ojimpo/mokkori-iq/data/swim/swim_20260621_171349.notes.md

# セッション記録 — swim_20260621_171349.csv

初プール採取（実機初の実データ）。外部GT（スマホ計測等）が無いため、**本人の泳ぎ方の記憶**と
**信号から検出した構造**を併記して疑似グラウンドトゥルースとする。解析の詳細は
`analysis/findings_2026-06-21_first_pool.md` / `analysis/approaches_log_2026-06-21.md`。

## 基本情報
- 日付: 2026-06-21（ファイル名のタイムスタンプ 17:13:49 は吸い出し時刻）
- プール: 25m・市民プール
- 装着: 股間。SeeedStudio 印字面=外側、USB-C 端子=上。
- センサ: 52Hz / 6軸 / |acc|平均 ≒ 1g（健全）。記録長 46.3分・144,360サンプル。

## 本人の泳ぎ方（記憶ベース＝主観GT）
- **狙ったメニュー**: 自由形 100m × 5本 × 2セット ＝ 1000m。間の長休憩で前半/後半に分割（「気分的には」＝厳密でない）。
- **ターン**: クイックターンはできない。**オープンターン**＝毎回プールの底に足をついて立ち、壁を蹴って再スタート。
  市民プールなので基本は足つき（たまに着いていない可能性あり）。
- **100mごとの区切り**: 水から上がらない。**数秒だけ立って静止 → 股間をトントン(3タップ) → すぐ泳ぎ出す**。
- **長休憩**: ハーフ間の1回だけ。**ベンチに腰掛けて数分**（その前後に約10秒の立位/歩行で出入り）。
- **自己申告の不確か要素**:
  - トントンは水中（立った状態）で打っている。水上には出ていない。
  - 100m 泳げていないインターバルが数本ある気がする（1本くらい本数を間違えた感覚）。
  - ペース体感 ≒ 30s/25m（≒2:00/100m）。

## 信号から検出した構造（客観）
- **前半 (0–944s)**: ウォームアップ + 100/100/100/**175m**（前半 rep2–4 は3ターンで教科書通り100m。rep5 は区切らず続けた≒175m）。
- **大休憩 (944–1511s, ≒9.5分)**: ベンチ着座（gz が +9.5 に張り付き）。
- **後半 (1511–2776s)**: 100/**325m(連続)**/50/200m。連続325m区間は止まらないので境界信号が無い。
- **合計（当時の集計）**: ≒**1150m**、moving 22:20、平均ペース ≒1:57/100m、総経過 46:16。
  - **2026-07-28 再集計（verticality＋リズムリカバリ後）**: 前半レップ5 に 724s の壁を1本復元 → 前半 **500m（意図「WU+100×4=500m」と一致）**、
    後半は連続325mが立ち休止で分割され 100/125/50/50/100/50/25/175。**合計 1175m**・ペース≒1:53/100m。
    ただしタップ三連（901/938s）の復元は射影シグナルでは失われた（検出器の既知トレードオフ）。
- **ストローク率**: 約 **30 cyc/min（≒60 strokes/min）**、前後半とも安定。
- **境界の見え方**: 100m境界の立位エピソードは **7–17秒**（減速+静止+トントン+蹴り出し）で、途中ターンの **≒3秒** と明確に分離。
  トントンの jerk 三連も長い静止と一致して復元できる（例: 901/938s）。

## 主観 vs 客観のズレ（疑似GTとしての注記）
- 「100m×5×2＝1000m」狙い vs 検出1150m。前半は意図500mとほぼ一致。後半は連続泳ぎが入り構造が崩れた（rep5≒175m、連続325m等）。
  → 「数本100m無い気がする」「1本間違えた」という本人感覚と整合（区切らず続けた／崩れた区間が実在）。
- 「数秒休憩」の体感 vs 実測7–17秒。減速・トントン・蹴り出しを含むため。

## このセッションの教訓（次回採取への申し送り）
- 距離・ペース・ラップは **トントンが無くても gz 検出で出る**。ただし **完全連続で泳ぐと「何本目か」は失われる**（距離は残る）。
  → 各本の区切りを残したいなら、長く泳いだ後も**一度は数秒止まる**。
- トントンは有効。打つなら**しっかり足をついて立ち・静止して・等間隔**で（移動中・半立ちだと埋もれる）。
- 装着向きは毎回そろえる（gz 検出は向き前提。静止区間の重力ベクトルから事後復元も可）。
