ojimpo/mokkori-iq/data/swim/swim_20260728_153415.notes.md

# セッション記録 — swim_20260728_153415.csv

2回目のプール採取（前回 2026-06-21 から約5週間ぶり）。外部GT無しのため、本人の記憶と
信号から検出した構造を併記して疑似グラウンドトゥルースとする。

## 基本情報
- 日付: 2026-07-28（ファイル名のタイムスタンプ 15:34:15 は**吸い出し時刻**。6/21 と同じくフラッシュ吸い出し時に自動命名される）
- プール: 25m・市民プール
- 装着: 股間。**向きは無造作**（前回の「Seeed面外側/USB-C上」の取り決めを守らず適当に入れた）。
  → 泳ぎ中の重力 ≒ (0, +3.9, −7.4)、立位で gy ≒ +9.6。前回の「gz スイング」前提が崩れた実データ。
- センサ: 52Hz / 6軸 / |acc|平均 ≒ 1g（健全）。記録長 52.5分・163,840サンプル＝**フラッシュ満杯で停止**。

## 本人の記憶（主観GT）
- **自分の感覚カウントで 625m** 泳いだところで市民プールの休憩時間になった。
- 休憩時間中は**椅子（ベンチ）に座ってしばらく休み**、そのあと残りを泳いだ。
- 泳ぎ終わった後も**シャワーを浴びる時までそのまま記録し続けた**つもりだが、気づいたら**赤ランプ（点滅=フラッシュ満杯）**になっていた。
- タップ（トントン）による区切りは今回は打っていない。

## 絶対時刻のアンカー（後から復元、2026-07-28）
デバイスに RTC が無いので記録は相対時刻のみ。本人の「**プールの建物を出たのが 14:27、その約15分前まで泳いでいた**」から逆算:
- 泳ぎ終わり（最後の壁 t=2430s） = **14:12:00** → 記録 t=0 = **13:31:30**
- 泳ぎ開始（t=448s） = **13:38:58** ／ 泳ぎ区間 = 13:38:58–14:12:00（実経過 33:02、うち泳ぎ 20:35）
- 記録終了（t=3151s、フラッシュ満杯） = **14:24:00** → 建物を出た 14:27 まで3分。
  「泳ぎ終わり→シャワー・更衣（12分）→満杯→3分後に退館」と辻褄が合い、**独立アンカーによる裏付けになっている**
- これは Phase 2 の BLE 時刻同期（`docs/ble_time_sync_design.md`）が自動化する作業そのもの。今回は手動アンカーで代用した

## 信号から検出した構造（客観）
- **0–7.5分**: 入水前（更衣・移動・シャワー等、直立姿勢主体）。
- **泳ぎブロック1 (448–1245s, 12.2分)**: 壁立ち 24回を検出（23回は直接検出、533s の浅いクイックタッチ1回は
  リズムリカバリで復元）。約30秒間隔で極めて等間隔。**24壁 → 25本 = 625m ＝ 本人の感覚カウントと完全一致**。
- **休憩 (約1245–1880s, ≒10分)**: ベンチ着座。座位は立位より重力偏差が大きい（verticality ≒ +13.5 に張り付き）。
- **泳ぎブロック2 (1880–2430s, 8.4分)**: 壁立ち16回 → 17本 = **425m**。こちらも約30秒間隔で等間隔。
- **2430s以降**: 退水 → シャワー・更衣（直立/雑多な姿勢）→ 3151s（52.5分）で**フラッシュ満杯により記録停止**。
  レポートがこの区間の偽ブロックを正しく除外（泳ぎ時間が短すぎるため）。
- **合計**: **1050m**（625+425）、moving 20:35、ペース ≒1:58/100m。
  **本人確認により完全一致（狙い1000m＋最後に50m多めに泳いだ）＝この検出は保守値ではなく正解**。
  これを根拠に保守バイアス方針を撤廃した（2026-07-28。CLAUDE.md「メトリクス算出方針」参照）。
  （リズムリカバリ実装前の初回集計は 1025m＝浅い立ち1回の棄却分。壁・ペース両推定の一致で 625m に確定）
- **ストローク率**: 約 30 cyc/min（≒60 strokes/min）、前回と同じ。

## このセッションの意義
- **装着向き無造作でも検出が成立することを実証**。この採取を受けて `turn_stand.verticality()` を実装:
  セッション内で泳ぎ姿勢/立位姿勢の重力を自己キャリブレーションし、泳ぎ→立位軸への射影で向き非依存化。
- 体感 625m と検出 625m の一致、および合計1050mの完全一致は、等間隔壁立ち検出の精度の強い裏付け。

## 教訓（次回への申し送り）
- 向きを揃えなくても距離・ペースは出る。**浅い/短い立ち（クイックタッチ）は直接検出では落ちる**ことがあるが、
  リズムリカバリ（等間隔事前分布＋弱い姿勢候補）で復元できる（今回の1本で実証）。
- 泳ぎ終わったら**なるべく早く電源OFF**。今回はシャワーまで回して満杯になった（データ自体は保全されるが、
  容量52分の残りを使い切る＝長いセッションだと後半が録れなくなるリスク）。
- **退館時刻など「絶対時刻の手掛かり」を1つメモしておくと時刻復元ができる**（今回は 14:27 の退館でセッション全体が確定した）。
  BLE 時刻同期が入るまでの当面の運用として有効。

## Strava 投稿 (2026-07-28)
本セッションを Strava へ手動アクティビティとして投稿（activity 19495824277「お昼のスイム」）。
表示は 1,050m / 20:35 / 1:57.6 per 100m / 開始 13:38:58 JST。投稿方針は CLAUDE.md「Strava 投稿の規約」参照。
