ojimpo/mokkori-iq/analysis/fig_eval_timeline_Freestyle.png

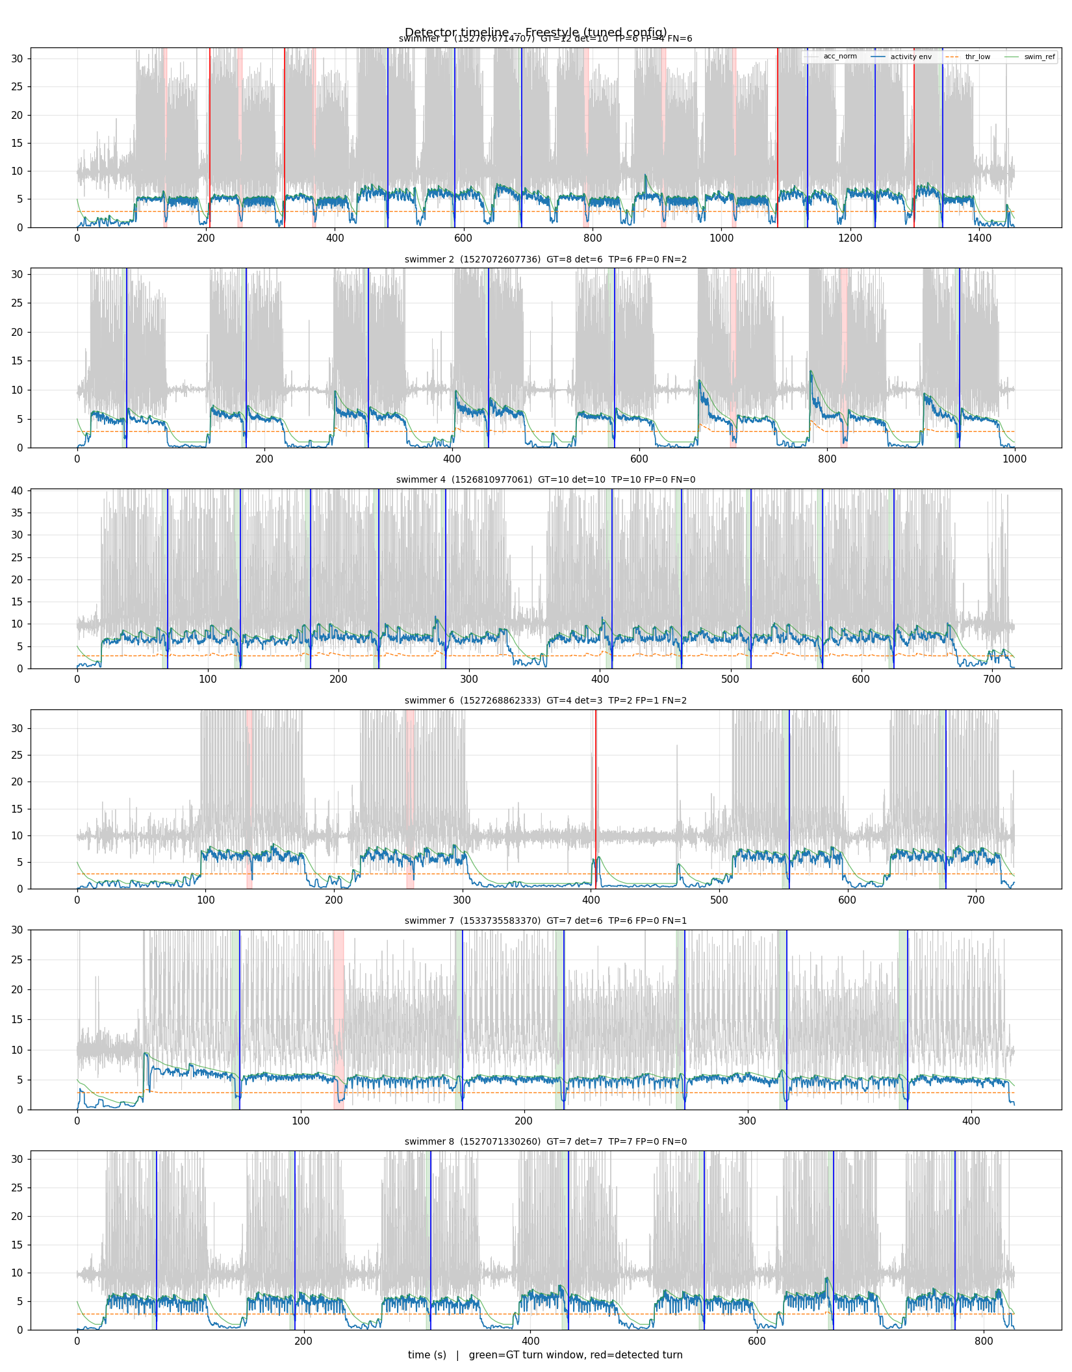
analysis/fig_eval_timeline_Freestyle.png
