ojimpo/mokkori-iq/analysis/fig_segment_swim_20260621_171349.png

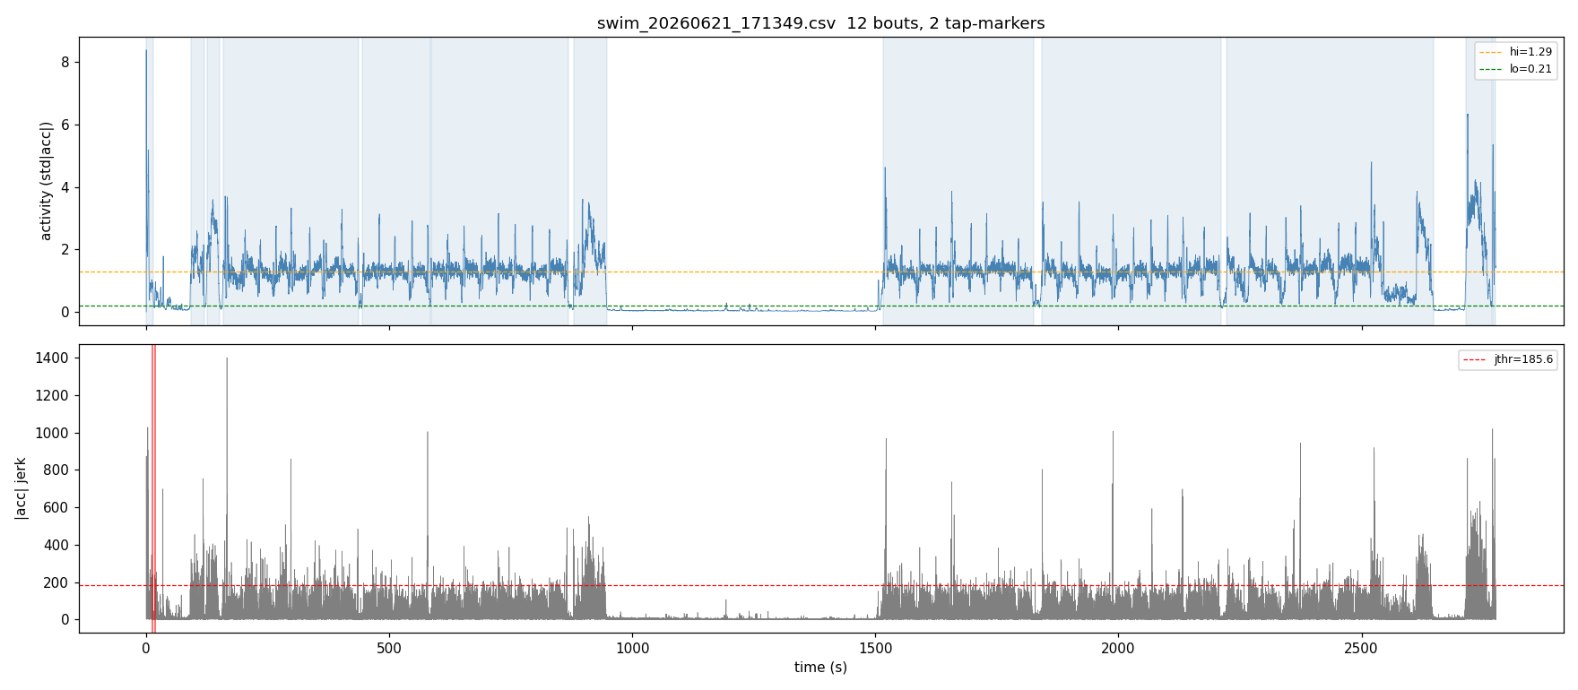
analysis/fig_segment_swim_20260621_171349.png
