ojimpo/mokkori-iq/analysis/fig_spm_swim_20260621_171349.png

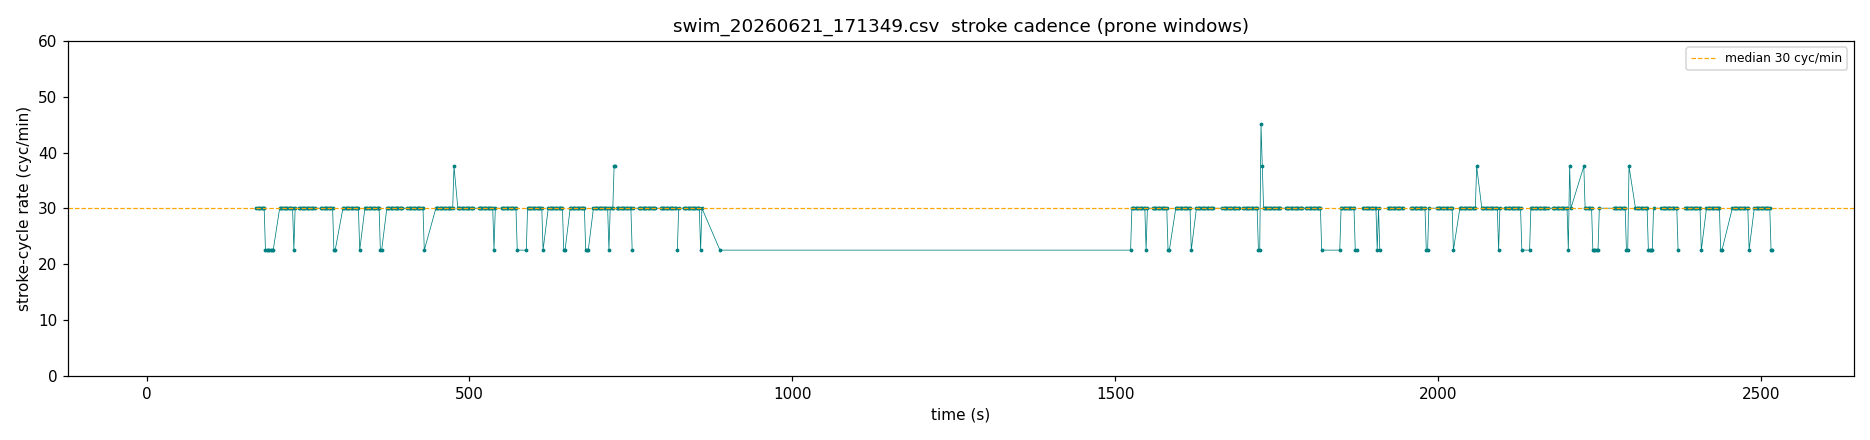
analysis/fig_spm_swim_20260621_171349.png
