ojimpo/mokkori-iq/analysis/fig_spm_swim_20260728_153415.png

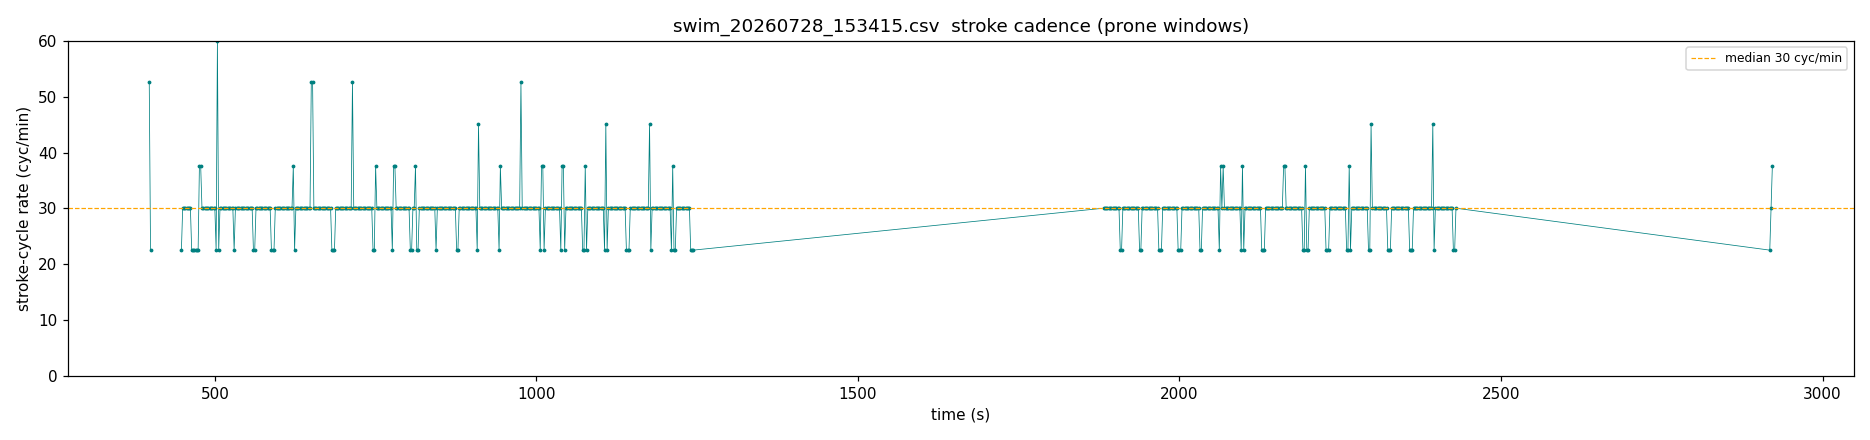
analysis/fig_spm_swim_20260728_153415.png
