ojimpo/mokkori-iq/analysis/fig_stand_swim_20260621_171349.png

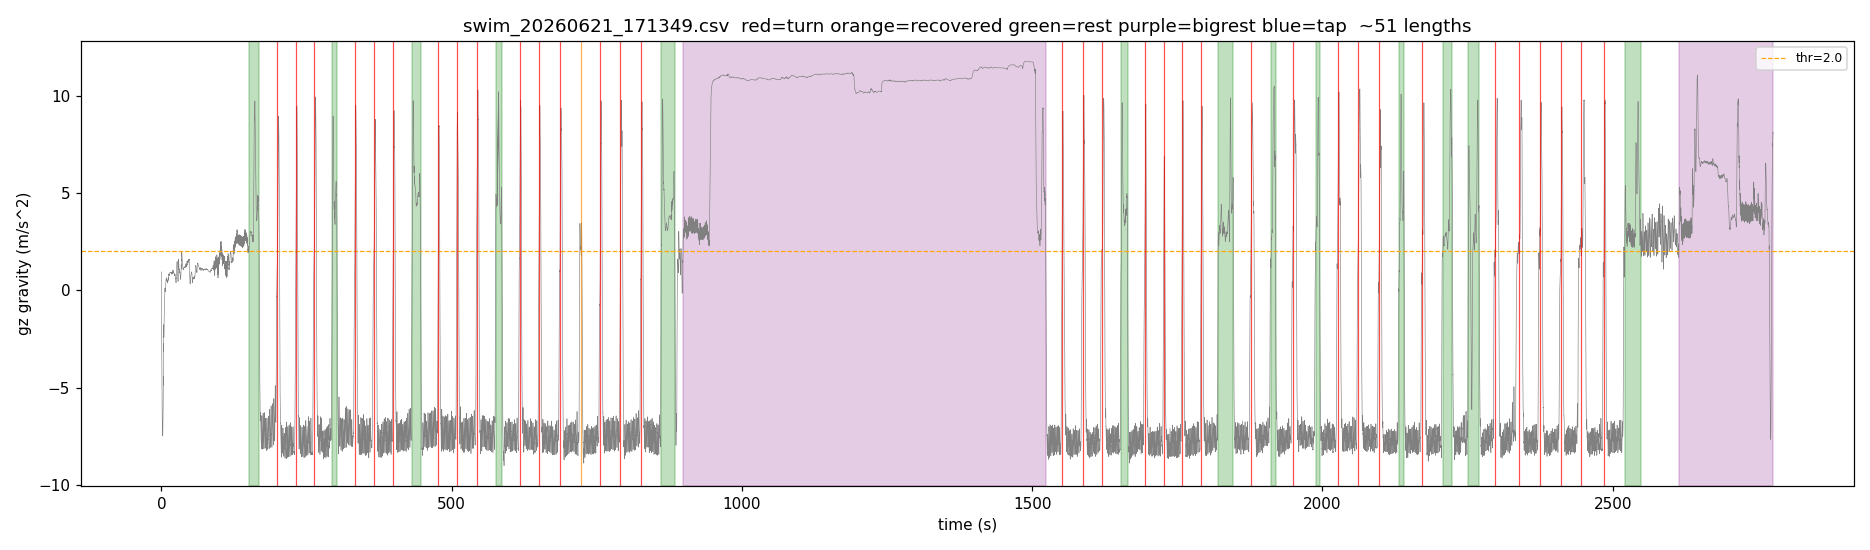
analysis/fig_stand_swim_20260621_171349.png
