ojimpo/mokkori-iq/analysis/fig_stand_swim_20260728_153415.png

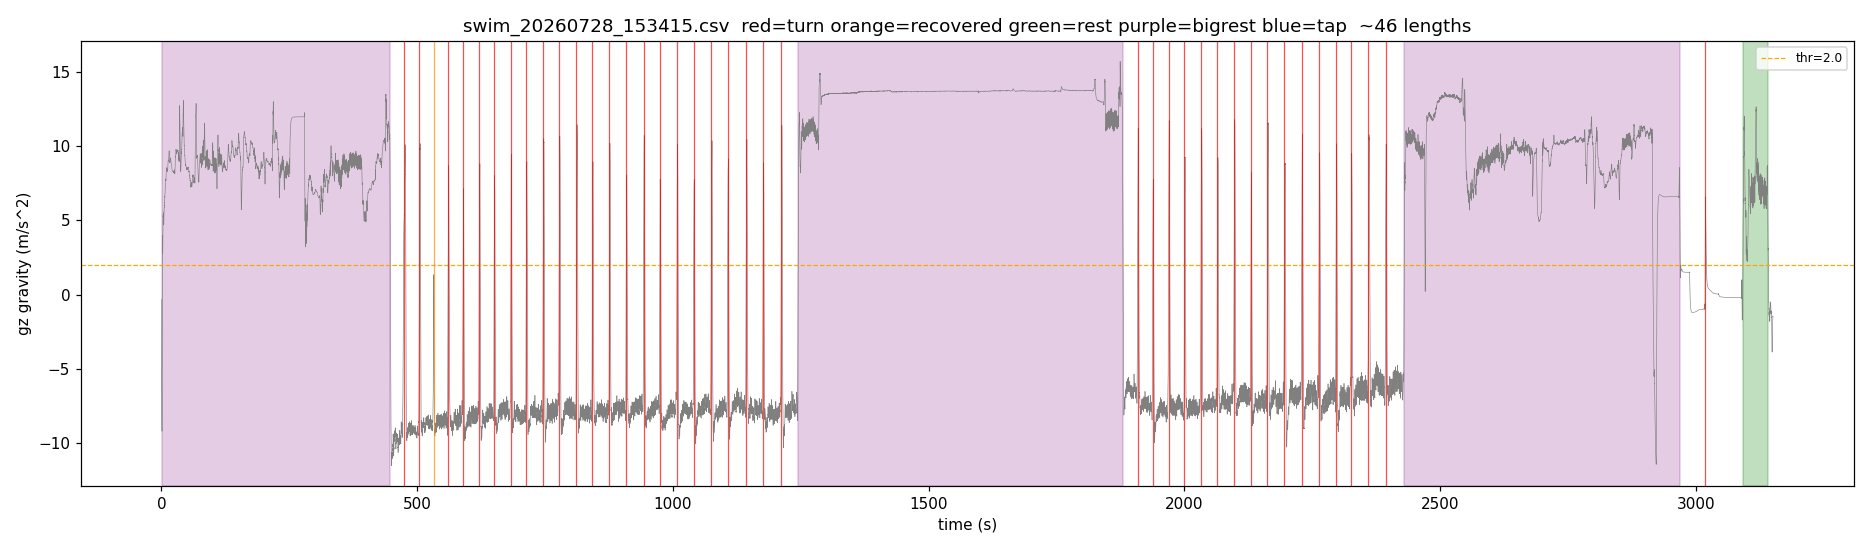
analysis/fig_stand_swim_20260728_153415.png
