ojimpo/mokkori-iq/analysis/fig_suspect_sessions.png

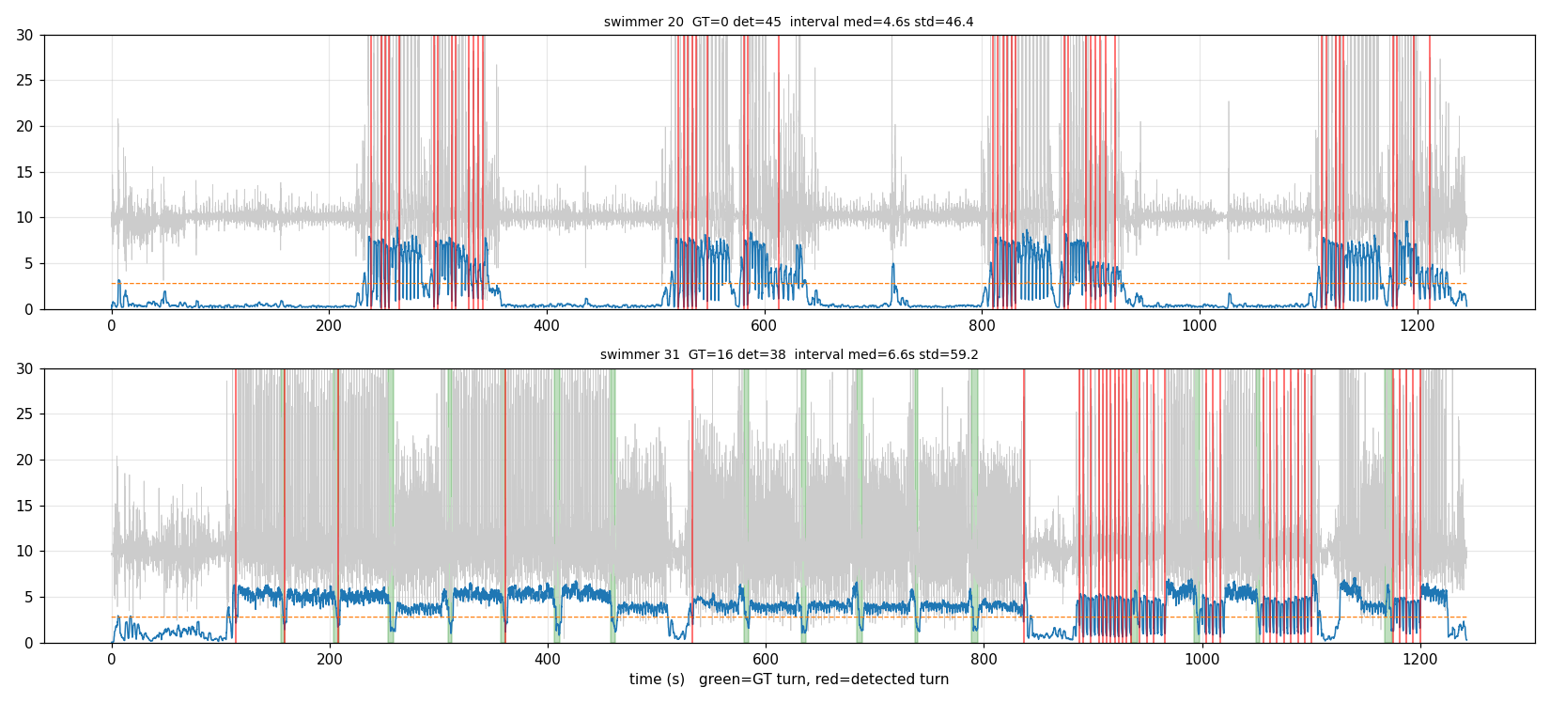
analysis/fig_suspect_sessions.png
