ojimpo/mokkori-iq/analysis/fig_turn_aligned_by_style.png

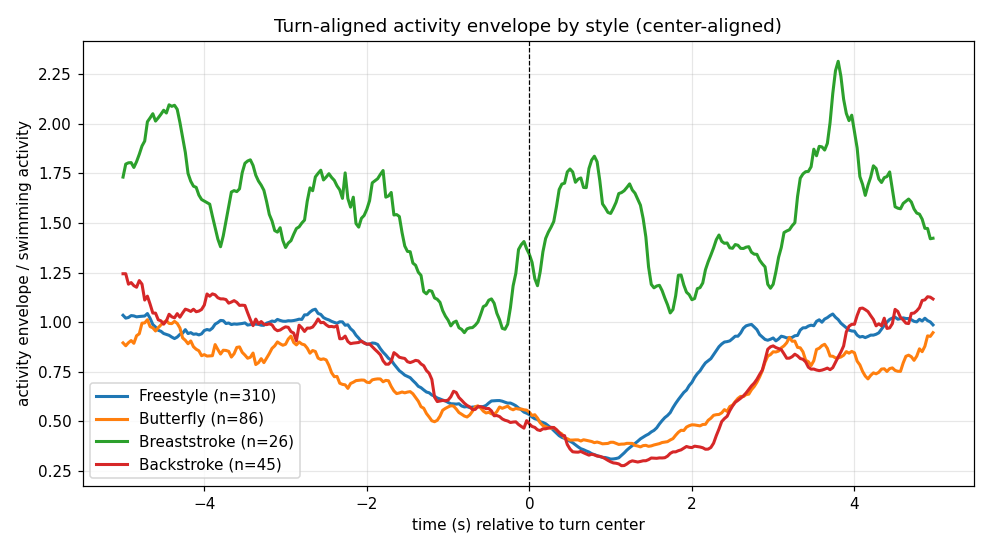
analysis/fig_turn_aligned_by_style.png
