ojimpo/mokkori-iq/analysis/fig_turn_examples_freestyle.png

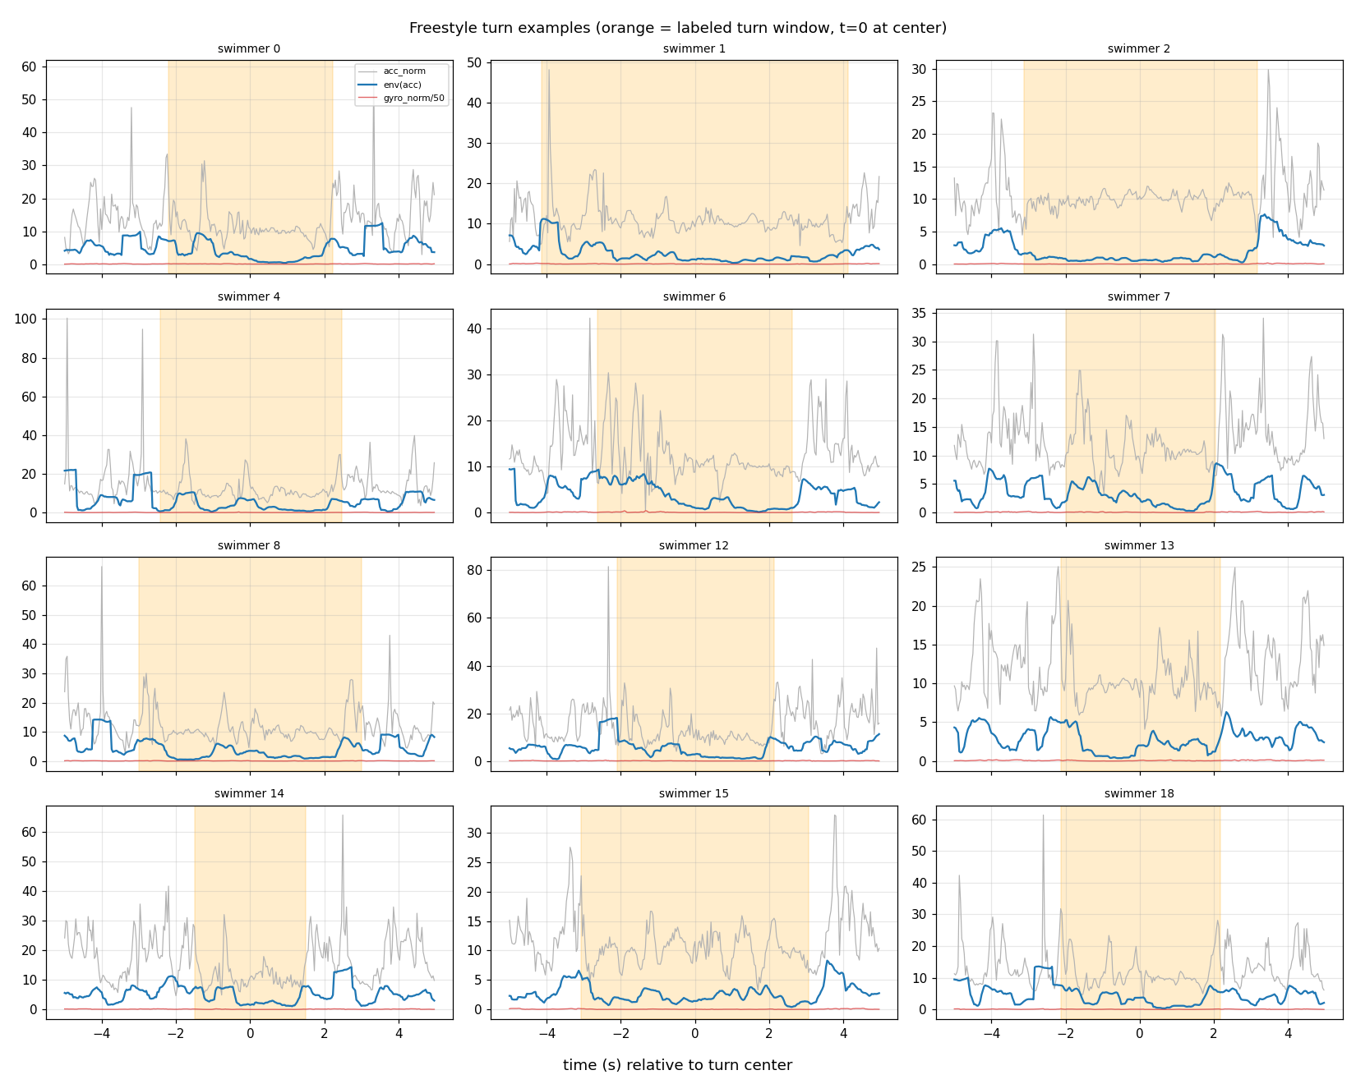
analysis/fig_turn_examples_freestyle.png
