ojimpo/mokkori-iq/results/per_session_Butterfly.csv

swimmer | style | epoch_ms | n_gt_turns | n_det_turns | tp | fp | fn | count_exact | count_within1 | drift_s | lap_mae_s
2 | Butterfly | 1527503549865 | 0 | 0 | 0 | 0 | 0 | 1 | 1
2 | Butterfly | 1532600827326 | 0 | 1 | 0 | 1 | 0 | 0 | 1
5 | Butterfly | 1532514905888 | 0 | 4 | 0 | 4 | 0 | 0 | 0
5 | Butterfly | 1532515337440 | 0 | 1 | 0 | 1 | 0 | 0 | 1
6 | Butterfly | 1527269602116 | 1 | 3 | 1 | 2 | 0 | 0 | 0
6 | Butterfly | 1527270435726 | 0 | 3 | 0 | 3 | 0 | 0 | 0
7 | Butterfly | 1527678406916 | 0 | 0 | 0 | 0 | 0 | 1 | 1
7 | Butterfly | 1531502229656 | 0 | 0 | 0 | 0 | 0 | 1 | 1
7 | Butterfly | 1531502371531 | 0 | 0 | 0 | 0 | 0 | 1 | 1
7 | Butterfly | 1532367411257 | 3 | 0 | 0 | 0 | 3 | 0 | 0
7 | Butterfly | 1533736091058 | 7 | 6 | 6 | 0 | 1 | 0 | 1 | 1.966666666820288 | 2.020000000157805
10 | Butterfly | 1527675371693 | 9 | 10 | 4 | 6 | 5 | 0 | 1 | 2.633333331687709 | 0.2999999998750127
10 | Butterfly | 1531393764517 | 0 | 0 | 0 | 0 | 0 | 1 | 1
10 | Butterfly | 1531393903093 | 0 | 0 | 0 | 0 | 0 | 1 | 1
10 | Butterfly | 1531394005449 | 0 | 0 | 0 | 0 | 0 | 1 | 1
11 | Butterfly | 1526814353094 | 0 | 0 | 0 | 0 | 0 | 1 | 1
11 | Butterfly | 1526814665313 | 0 | 0 | 0 | 0 | 0 | 1 | 1
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
