ojimpo/mokkori-iq/DEVLOG.md

# 開発日誌 — mokkori-iq

Cosense「mokkori-iq 進捗ログ」のミラー。時刻は JST（ツール実行タイムスタンプ ≒ 作業時刻の近似）。
2026-07-11 開始。それ以前の経緯は CLAUDE.md・git log を参照。

## 2026-07-11

### 振動モーター購入（Amazon、Claude Code 着手前）
- JYUDAUFU コイン型 ERM 10mm×2.7mm、20 個入り
- 定格 DC 3V / 最大 80mA / 12000rpm / 動作電圧 3〜4.2V / リード線 27mm
- 5 月選定の C1027 と同等クラス。駆動系部品（BSS138 / 1N4148 / SOT-23 変換基板 / ユニバーサル基板ほか）は 6/28 に秋月八潮で調達済み

### 16:13 flash_logger に振動モーター駆動を実装（Claude Code）
- 低サイドスイッチ回路を確定:
  - `3V3 → モーター(+)` / `モーター(−) → BSS138 ドレイン` / `ソース → GND`
  - `D10 →[100Ω〜1kΩ]→ ゲート`、`ゲート →[100kΩ]→ GND`（ブート中のフロート対策プルダウン）
  - 1N4148 をモーター両端に並列（**カソード = 3V3 側**、フライバック吸収）
- ピンは **D10**: 右側ヘッダで 3V3・GND と同列に並ぶため、ユニバーサル基板の配線が片側に集まる
- コンソールに `VIB [ms] [pct]` を追加（既定 500ms / 100%。PWM duty で強度も試せる）
- **記録中（プール）は 60 秒ごとにダブルパルス**（200ms ON / 200ms OFF / 200ms ON）を非ブロッキングで自動発振
  - 「筐体＋水着越しに水中で体感できるか」（5 月からの未検証課題）を次回採取と同時に検証できる
  - 既知タイミングなので IMU データから識別・除外可能。記録開始の触覚確認にもなる
- モーター制御は `analogWrite` に統一（nRF52 コアで digitalWrite との混在を避ける）。セッション終了時に必ず OFF
- コンパイル確認済み（62988 bytes / 7%）。実機書き込み・動作確認はモーター実装後
- 知見: CLAUDE.md の相対 `PATH=".venv/bin:$PATH"` は Go の exec 制約で arduino-cli のビルド後処理が失敗する（`cannot run executable found relative to current directory`）→ `PATH="$PWD/.venv/bin:$PATH"` と絶対パスで通す（CLAUDE.md 修正済み）

### 16:42 BSS138 を SOT-23→DIP 変換基板（AE-SOT23-3-DIP4）へ実装（手作業）
- 1個目で成功（パッド1箇所予備半田 → 位置決め → 残り2本の順）
- 変換基板のレイアウト: 単脚側（ドレイン）が同じ側の DIP 2ピン**両方**へ分岐、二脚側（G/S）が反対側の 2 ピンへ独立に出る
- **ピン対応の確定（写真判定）**: 印字面を上・単脚(D)側を上に向けたとき、**下左=ゲート(pin1) / 下右=ソース(pin2) / 上2ピン=ドレイン(pin3, 同電位)**。SOT-23 は裏返し実装が物理的に不可能なので向きはこれで一意
- 裏取り方法: テスターのダイオードモードで 赤=S・黒=D → 0.5〜0.7V（ボディダイオード）、逆は OL。測定前に3ピンをつまんでゲート帯電を抜く
- 配線先: 上側どちらか1ピン→モーター(−) / 下左(G)→100Ω〜1kΩ→D10 ＋ 100kΩ→GND / 下右(S)→GND

### 17:33 電源スイッチの防水方針を決定（設計メモ、実装なし）
- 発端: スイッチを基板に実装すると操作のため筐体を露出させる必要がある → 防水スイッチを買うべきだったか？の相談
- **決定: 現行のスライドスイッチ（SS-12D00G3）はプロトタイプ用と割り切る。最終形（完全封入筐体）では物理スイッチの穴自体を廃す**
- 理由: 防水スイッチ製品（ゴムブーツ/シリコンキャップ付き IP67 等）は存在するが、**可動シール部が必ず経年で浸水経路になる**。股間装着＝水圧＋密着で最も過酷なので可動部シールは避けたい。Cosense 防水検討の「開口部ゼロの完全封入」思想とも矛盾する
- 最終形の置き換え候補（穴ゼロ）:
  - **マグネット式**: リードスイッチ（数十円・外から磁石を近づけてON）or ホールIC ラッチ型（磁極でトグル）。筐体は密閉のまま外側に磁石を当てて操作
  - **タップ起動**: Phase 2 BLE 設計と同じ思想を電源にも延長。物理スイッチを廃し nRF52840 常時ディープスリープ（5μA）＋加速度タップで起床。数週間放置は余裕、数ヶ月放置は自己放電が効く
- 今回のプール採取は現行スライドスイッチのまま進める（完全防水はまだ先送りの方針＝Cosense「USB-Cをキャップで塞ぐだけで検証優先」と一致）。今のスイッチはプロト検証用に使い切る＝無駄にならない

### 20:42 ユニバーサル基板の配線レイアウトを確定（座標付き図・`docs/motor_perfboard_layout.html`）
- 基板現物: 上下2列のピンソケット（XIAO用 7ピン×2、列1–7）が実装済み。右側（列8–12）が空きエリア
- 座標系を定義: **列1–12 × 行A–G**。上ソケット行=A、下ソケット行=F、最下空き行=G
- **XIAO 向き = USB-C 左・部品面上**。手前の行F が左から VUSB/GND/3V3/D10/D9/D8/D7 → 使うのは **F2=GND, F3=3V3, F4=D10**（隣接3ピン）
- XIAO 本体が列1–7・行A–F を覆うので、駆動回路は**右エリア（列8–9）＋GNDレール（行G）**に配置
- **BSS138 変換基板は 2×4 占有**（四隅パッドの外形が縦長）: 列8–9 × 行C–F。ドレイン端（単脚=2穴分岐）を上=行C、ゲート/ソース端を下=行F に向ける → C8/C9=ドレイン, F8=ゲート, F9=ソース。中央 行D/E は基板下で未使用
  - この向きの利点: ゲート(F8)・ソース(F9)が最下 GNDレール(行G)に隣接 → プルダウンとソース落としが最短
- 配線10本: ①F2→G2(GND起点) ②G2–G9レール ③F3→B8(3V3をゾーンへ) ④R1(100Ω–1kΩ) F4→F8 ⑤R2(100kΩ) F8→G8 ⑥1N4148 B8→C8(帯=3V3側) ⑦F9→G9(ソース) ⑧BSS138 ⑨モーター赤→B8(3V3) ⑩モーター青→C9(ドレイン)
- ゲート(F8)に R1・R2・BSS138ゲート足の3本が合流＝配置の中心。R1 は行F上を D10→ゲートへ飛ばす（間の D9/D8/D7 は足を浮かせて跨ぐ or 裏配線）
- 図は座標付き HTML（`docs/motor_perfboard_layout.html`、ライト/ダーク対応・スマホ可）。Artifact: https://claude.ai/code/artifact/7979c6ad-1030-4ff6-a30d-78a24db49a69
- 注意: 列数・行数は写真からの概算。実物のソケット位置に合わせて微調整。右に空き4–5列あれば足りる

## 2026-07-28

### 15:57 2回目プール採取の取込・向き非依存の壁検出を実装（Claude Code）
- タブレットから push された `data/swim/swim_20260728_153415.csv` を取込（52.5分/163,840サンプル/52Hz、|acc|≒1g健全）
- **記録は52.5分でフラッシュ満杯停止**＝本人が気づいた「赤ランプ」の正体（赤点滅=満杯）。泳ぎ終了後もシャワーまで記録を回したため容量を使い切った。泳ぎ本体は全部録れており実害なし
- **装着向きが無造作**（前回の Seeed面外側/USB-C上 を守らず）→ 泳ぎ中の重力が (0,+3.9,−7.4)、立位は gy≒+9.6 に出て、gz 決め打ちの `detect_walls` が原理的に効かないセッション
- **`turn_stand.verticality()` を新設して向き非依存化**:
  1. 泳ぎ姿勢の重力 = 高ジャイロ活動サンプルの中央値
  2. 立位姿勢の重力 = 「重力偏差の短い反復エピソード（1.2〜7s=壁立ち）」のピーク重力の中央値
  3. 泳ぎ→立位軸への射影を旧 gz スケール（−7.5↔+9.5）へ正規化 → 既存の閾値・分類・レポートはそのまま
  - キモ: 射影軸は**壁立ちにアンカー**。ベンチ座位は偏差がより大きい（15.6 vs 立ち11 m/s²）が方向が違い、座位軸に射影すると壁立ちが埋もれる（実測で確認）
- **結果**: 泳ぎブロック1 = 壁立ち24回・約30秒間隔で等間隔 → 25本 = **625m、本人の感覚カウントと完全一致**（市民プールの休憩時間まで）。ブロック2 = 16回 → 425m。レポート保守値 **1025m**・ペース≒2:00/100m・SPM 30（前回と同値）
  - 保守ルールが入水前7.5分とシャワー・更衣区間の偽ブロックを正しく除外。浅い立ち1回（peak不足）は棄却→600m計上（保守方針どおり距離は下振れ）
- **旧セッション回帰**: 距離は不変（475/675/計1150m）。ただし半2の「連続325m」が7〜26秒の立ち休止で分割されるようになった（3軸射影が斜め立ちを正しく拾うため。真偽は外部GT無しで未確定）。**タップ三連の復元は失われた**（ブリップが立ちエピソードに融合。必要なら立ちエピソード内 jerk で再実装）
- セッション記録は `data/swim/swim_20260728_153415.notes.md`（疑似GT）。図 `analysis/fig_stand_swim_20260728_153415.png` / `fig_spm_...png` 生成、6/21 の図も新検出器で再生成

### 16:14 リズムリカバリ実装＋疑似GT回帰ハーネス（Claude Code）
- 精度向上の検討: 両セッションの壁間隔は極めて等間隔（IQR幅2〜3秒）で、取りこぼしは各セッション1箇所だけ。どちらも「中央値の約2倍のギャップ＋中間に閾値未満の弱い立ち候補」という同じ形と判明
- **リズムリカバリを `detect_walls` に実装**: 泳ぎギャップ（立ち終わり→次の立ち始まり、立位時間除外）が中央値の1.6〜2.6倍、かつ中間に verticality>0（スイングの約45%超、泳ぎノイズ −7.5±1.5 から十分遠い）の候補がある場合のみ1壁補完。図ではオレンジ線
- **結果**: 既知の取りこぼし2箇所（6/21@724s ピーク3.5、7/28@533s 浅いクイックタッチ ピーク1.35）がどちらも復元、誤補完ゼロ
  - 7/28: 前半 600→**625m＝本人の感覚カウントと完全一致**、合計 **1050m**
  - 6/21: 半1 475→**500m＝意図（WU+100×4）と一致**、合計 **1175m**
  - レップ7（壁2/ペース1）以外の全レップで壁カウントとペース推定の独立2系統が一致。保守ルール min(壁,ペース) は不変＝距離を盛る変更ではなく、時間シグナルが既に支持する本数に壁が追いつくだけ（ラップ境界時刻も正確化）
- **`analysis/regression_check.py` 新設**: 各セッションの notes.md 由来の疑似GT（壁/rest/big数・復元位置±5s・半距離・総距離）をピン留め。検出器・レポート変更後に必ず実行、2/2 PASS。片方を直してもう片方を壊す事故を機械検出する
- 閾値のグリッドサーチ再チューニングは見送り（2セッションでは過学習リスク）。精度の本命は notes 付きセッションの追加採取

### 16:30 初の Strava 投稿（7/28セッション）＋絶対時刻の復元
- **絶対時刻を外部アンカーから復元**: デバイスにRTCが無く記録は相対時刻のみ。本人の「建物を出たのが14:27、その約15分前まで泳いでいた」から逆算し、泳ぎ終わり(t=2430s)=14:12:00 → 記録 t=0=13:31:30、泳ぎ開始(t=448s)=**13:38:58**
  - **裏付け**: 記録終了(t=3151s, フラッシュ満杯)=**14:24:00** で退館14:27の3分前。「泳ぎ終わり→シャワー・更衣12分→満杯→3分後に退館」と辻褄が合う＝独立アンカーで時刻復元が検証できた
  - ついでに notes.md の誤りを訂正: ファイル名の 15:34:15 は記録開始ではなく**吸い出し時刻**（6/21と同じ）
- **Strava 投稿方針をユーザーと確定（スマホアプリでも同じ挙動にする）**: ガーミン等の既製ウォッチと同じ見え方にする。**表示時間=泳ぎのみ(moving 20:35)**・休憩は含めない、**開始時刻=実際に泳ぎ始めた時刻**、距離は保守値のまま（説明文に「実際はこれ以上」）。実経過33:02は説明文に併記
- 認証は自作の別アプリ **strava-autopilot の資格情報を流用**（arigato-nas `~/dev/strava-autopilot/`。`.env` + `data/autopilot.db` の `oauth_tokens`、スコープに `activity:write` 込み）。アクセストークンが18:51まで有効だったので**リフレッシュせず使うだけ**にした（refresh するとトークンが回って autopilot 側が壊れうる）
- 手動アクティビティ `POST /api/v3/activities` で作成 → **activity 19495824277「お昼のスイム」**。Strava側表示 1,050m / 20:35 / **1:57.6 per 100m** / 開始13:38:58 JST / sport_type=Swim
  - 手動作成では moving=elapsed になる制約あり。レップ別スプリットまで出したくなったら TCX アップロード（Lap の `Intensity=Resting` で休憩表現）へ移行する
  - 注意: アカウント既定の公開範囲が `everyone`

### 16:42 保守バイアス撤廃＋立ちエピソードのデフラグ（根本原因修正）
- **ユーザー判断で保守バイアス方針を撤廃**。理由: ①距離ベースの**振動フィードバック**（Nmごとにブザー）を実装すると、少なめに出る距離はズレが累積して**間違った壁で鳴る**＝保守側が実害になる ②精度が実証された（7/28の1050mが「狙い1000m＋最後に50m多め」と**完全一致**）
- 撤廃前に「保守ルール min(壁,ペース) が実際どこで効いているか」を全24レップで調査 → **発火はたった1箇所**（6/21 @2224-2259s、壁2/ペース1）。他23レップは1本あたり26.4〜29.8秒でぴったり一致
- **その1箇所を掘ったら偽分割だった**: 2251-2255s の「turn」と 2259-2270s の「rest」は**同じ1回の壁立ちが4秒の谷で2分割**されたもの。つまり min() は「保守バイアス」ではなく偽分割の後始末をしていた
- **根本原因を修正（デフラグ）**: 間隔が `refractory`(12s) 未満の連続立ちエピソードは同一の壁として **union**（旧実装の「近すぎる turn を drop」ではなく union なので立ちの**真の終了時刻**が保たれる＝レポートの泳ぎ区間境界が正確になる）。合算スパンで再分類
  - 閾値の根拠: 実測ギャップは二峰性で、分断が 0.8〜8.4s／次の正当なギャップが 14.4s＝広い空白帯があるので 12s は安全圏（1本28秒なので本物の壁が4秒差で並ぶことは原理的に無い）
  - 該当4ペア: 6/21 @2251+2259(4.0s)・@2614+2774(4.3s)、7/28 @2430+2471(0.8s)・@2471+2924(8.4s)
- **結果: min() が両セッションで完全に不発**（全24レップで壁カウント＝ペース推定）。距離は 6/21 **1175m** / 7/28 **1050m** で不変＝バイアス撤廃で数値が変わらないことを確認した上で撤廃できた
- min() 自体は残す。ただし位置づけを「保守バイアス」から**「物理制約による妥当性クロスチェック」**へ変更（泳ぎ時間が許す以上は泳げない）。発火＝検出がずれているシグナルなので、レポートが `CROSS-CHECK` 行で**明示警告**する（黙って削らない）
- レポート/notes/Strava説明文から「控えめ・実際はこれ以上」を削除（activity 19495824277 の説明文も PUT で修正）。CLAUDE.md に**距離ベース振動の要件**を追記: 解析系の min()/リズムリカバリ/デフラグは**非コーザル**なので実機リアルタイムには別途コーザル壁カウンタが必要。リアルタイムで効くのは精度よりドリフトしないこと
- regression_check の期待値を更新（6/21 turns 37→35、7/28 rests 3→1＝マージ分）。2/2 PASS

### 16:49 Phase 2 設計追加: 壁インターバル確認画面＋処理オフロード（設計のみ）
- ユーザー発案の2決定を Phase 2 設計に追記:
  1. **取込後/Stravaアップ前に「壁インターバル表」の確認画面**: 壁を蹴ってから次に蹴るまでの時間を表形式で一覧し、明らかに変な行をユーザーが確認・修正（壁の追加/削除/マージ→即時再計算）してからアップする
  2. **重い処理はスマホへオフロード**: デバイスは「記録＋（振動用）コーザル壁カウンタ」だけ。非コーザル解析（verticality/リズムリカバリ/デフラグ/レポート）はスマホ側で実行
- 帰結として **C 移植のスコープが縮小**: フル検出器の C 移植は不要になり、C はコーザル壁カウンタのみ。解析パイプラインの移植先は Swift（Python 側がリファレンス実装）。生データは BLE フル転送（2MB ≒ iOS実効20〜40kB/s で1〜2分、時刻同期と同じ接続）
- 確認画面のハイライト規則は解析側の知見を流用: 中央値の≳1.6倍=壁見逃し疑い（リカバリ発動箇所は明示）、≲0.6倍=偽壁疑い、CROSS-CHECK不一致=行warning
- 設計上の意義: ①保守バイアス撤廃後の安全網が「人間の目」になる ②**修正ログがラベル付きGTとして蓄積**＝外部GT不在問題への構造的な回答（修正済みセッション=教師データ→検出器チューニングに還流）
- **生データはアプリ側に永続保存**（解析結果だけでなく）: 検出器を後から改良すれば**過去セッションも再処理して精度を引き上げられる**（6/21 を新検出器で 1150→1175m に再集計したのと同じことがアプリ内で起きる）。ユーザー指摘で追記

### 17:00 スマホアプリ開発プラン策定（docs/phase2_app_plan.md、実装は次セッション）
- アプリ開発を開始する判断。ただしセッションが長くなったので**このセッションはプラン策定まで**、実装は次セッションから
- Todoist 開発/mokkori-iq を確認: 「バッテリー残量」タスクは実は7/11実装済み（残り=実機書込検証のみ、モーター版ファームと一緒に焼く）と判明→タスク更新・p3へ。「ログに現在時刻」はプランの Phase C/D に統合
- **`docs/phase2_app_plan.md` を策定**。フェーズ分割の要点は「**BLEを待たずにアプリの大半を作れる順序**」:
  - Phase A: 解析エンジンの Swift 移植＋壁インターバル確認画面（BLE不要。既存CSVのファイル取込で動かす）。**パリティテスト**が肝: XCTest で regression_check.py と同じ期待値（6/21=1175m, 7/28=1050m他）を固定し、Pythonと同一結果になったら移植完了
  - Phase B: Strava アップロード（OAuth は新規登録 or autopilot 流用を最初にユーザー判断。手動アンカー入力UIをBLEまでのつなぎで）
  - Phase C: ファーム時刻アンカー＋TIMES（USB完結、Aと並行可）／ Phase D: BLE（ファーム+アプリ、通ったらタブレット引退）／ Phase E: 仕上げ（SPM移植・一括再処理・修正ログ書き出し=GT還流）
- 配置は **mokkori-iq リポジトリ内 `app/`**（別リポにしない）: Python がリファレンス実装でパリティテストが data/swim と期待値を直接参照するため
- Todoist に Phase A（p1）/ Phase B（p2）タスクを追加。次セッションは「docs/phase2_app_plan.md を読む」から

### 17:07 本ごとストローク数の実証＋ガーミン互換メトリクスのマトリクス化
- ユーザー要望「25mごとのストローク数」「ガーミンで見れる指標をできる限り」を受けて実データで検証
- **本ごとのストロークカウントは取れる（実証）**: 壁間の泳ぎ区間ごとに最良ジャイロ軸を 0.3–1.2Hz バンドパス→ゼロクロスで実カウント。両セッションとも**中央値15サイクル/25m（IQR 14–15）**、スペクトル推定（周波数×時間）と中央値±1以内で一致＝2手法クロスチェック成立
- **単位の対応が好都合**: ガーミンの腕時計は「時計側の腕のストローク数」を数える仕様。股間のロールサイクル（左右1往復=1）はまさに片腕ストロークと1:1なので、**ロールサイクル数がそのままガーミンのストローク数と同じ土俵**。SWOLF≈29+15=44、DPS≈1.67m/cycle も妥当なレンジ
- 注意点: ウォームアップ/退水を含む区間は prone ゲート必須（6/21 の先頭150s区間で125カウントのゴミ実例）
- **docs/phase2_app_plan.md にガーミン互換メトリクスの実装可否マトリクスを追記**: 実装済み=距離/本数/時間/ペース/ストローク率/セット構造、実証済み=本ごとストローク数、容易=SWOLF/DPS/ベストペース、概算=カロリー、不可=心拍系（センサ無し）、保留=泳法判定（自由形のみ運用）
- Todoist に「swim_report に本ごとメトリクス追加」タスク（p2）を追加。Phase A の Swift 移植より先に Python リファレンスを作る順

### 17:30 Phase A 着手: 解析エンジンの Swift 移植、パリティテスト一発 green
- `app/MokkoriCore` を Swift Package として作成（iOS 17+ / macOS 14+ 両対応）。**macOS でもビルドできるので `swift test` が Xcode 不要で回る**＝パリティテストを Mac の CLI で高速に回せる構成
- 移植内容: CSV ローダ（g→m/s²・dps→rad/s 変換＋fs 推定）/ numpy 互換 median・percentile（linear 補間）/ EMA / verticality 自己キャリブレーション / detect_walls（分類→デフラグ union→リズムリカバリ→タップ三連）/ swim_report の距離計算（typical length time・レップ分割・min() 物理制約）
- **パリティテスト green（一発）**: regression_check.py と同一期待値（6/21: turns35/rests13/bigs2/復元@724s/500+675=1175m、7/28: turns41/rests1/bigs3/復元@533s/625+425=1050m）を XCTest でピン留め、両セッション PASS。全レップで CROSS-CHECK 不発（min() が効かない）も性質としてピン留め
- 移植の要注意点（ハマり回避の知見）:
  - `np.percentile` は linear 補間、`np.median` は偶数長で中央2値平均。Swift 側もこの定義に合わせないと閾値（percentile(act,60)・percentile(dev,99)）が微妙にズレて episode 境界が動く
  - Python の `round()` は**偶数丸め**（banker's rounding）→ ペース推定本数は `.rounded(.toNearestOrEven)` で移植
  - 全計算 Double。プラン想定どおり
- **int16 バイナリ永続化（RawRecording）**: CSV↔int16 の完全ラウンドトリップを実装・検証（感度 = accel 8/32768 g/LSB、gyro 70mdps/LSB。CSV 値=round5(raw×感度)、t=round4(i/odr) を利用）。**バイナリ経由でも CSV 直読みとビット単位で同値**＝保存形式の違いで解析結果が変わらないことをテストで担保。9.6MB CSV → 約2MB
- **編集オーバーレイ（WallOverlay）**: 壁の追加/削除を生データ・自動検出と分離して保存（プランの「修正ログ=ラベル付きGT」の器）。**壁インターバル表（WallIntervalTable）**: ブロック内中央値の ≥1.6倍=見逃し疑い / ≤0.6倍=偽壁疑い / リカバリ壁の明示、をコア側で行計算（テスト可能に）

### 17:45 iOS アプリ本体（app/MokkoriIQ）: 3画面実装、シミュレータでビルド・起動確認
- XcodeGen 導入（`project.yml` をコミット、`.xcodeproj` は生成物で gitignore）。SwiftUI / iOS 17+ / iPhone 専用 / ローカルパッケージ MokkoriCore 依存
- **永続化**: `Documents/sessions/<uuid>/` に meta.json（一覧用サマリキャッシュ込み）+ raw.bin（int16）+ overlay.json（人手修正）。量子化ラウンドトリップに失敗する形式は raw.csv フォールバック。時刻アンカー（startEpoch）は Phase B/C 用の器だけ用意
- **画面**: セッション一覧（fileImporter で CSV インポート・スワイプ削除）→ レポート（距離/ペース/泳ぎ時間/半分割/レップ内訳/CROSS-CHECK 警告）→ **壁インターバル確認画面**（ハイライト・「補完」バッジ・スワイプ/コンテキストメニューで壁の追加/削除（=隣接マージ）→ 即時再計算・修正の全破棄）。編集で一覧サマリも追随更新
- **環境のハマり（次回のため）**: Xcode 26.6 は iOS 26.5 シミュレータランタイム必須。手元は 26.4 しか無く destination が1つも出ない状態 → ディスク残 11GB だったので使えない 26.4（7.9GB）を削除してから `xcodebuild -downloadPlatform iOS`（8.5GB）で 26.5 導入。CoreSimulator が古い警告は `launchctl remove com.apple.CoreSimulator.CoreSimulatorService` で解消
- SwiftUI の罠: `Section("タイトル") { } footer: { }` という初期化子は無い → `Section { } header: { } footer: { }` に
- 検証: iPhone 17 Pro シミュレータでビルド成功・起動・セッション一覧の表示確認（コンテナに 7/28 セッションを直接投入して 1,050m / 20:35.5 の行表示を目視）。画面遷移の操作確認は Xcode から手で行う（osascript の補助アクセス権が無く自動タップ不可）
- 残: SPM 表示（コア未移植）、手動時刻アンカー UI + Strava（Phase B）、実機 iPhone 確認。CLAUDE.md に Phase A 実装状況とビルドコマンドを追記

### 18:05 本ごとメトリクス実装（Python リファレンス → Swift 同値移植）
- プランの実装順どおり「Python 側をリファレンスにしてから Swift へ」を一気に実施。**ストローク数/SWOLF/DPS/ベストペースが swim_report.py・MokkoriCore・アプリのレポート画面すべてに入った**
- 実装方式: 17:07 のスクラッチ検証（scipy バンドパス→ゼロクロス）を**移植容易なプリミティブで書き直し**: RBJ constant-peak-gain バンドパス biquad（因果 DF2T、0.3–1.2Hz）→ prone ゲート付きヒステリシスゼロクロス（閾値 0.3×RMS）→ 最良ジャイロ軸選択は prone 帯域パワー最大。FFT 不使用なので Swift と完全同一算術にできる
- 本の定義 = 壁を蹴った時刻（立ち終わり）→次の壁到着（立ち始まり）。立位時間は構造上含まれず、SWOLF = 本タイム + ストローク数がガーミンと同じ土俵になる
- **結果（両セッションで安定）**: 中央値 14 ストローク/本（IQR 13-14）・SWOLF 平均44 ベスト38・DPS 1.79m/cycle・ベストペース 1:42-1:44/100m。6/21 = 47/47本計測 合計647、7/28 = 42/42本 合計576。prone ゲートによりウォームアップのゴミカウント（125カウント事例）は消滅
- 注: スクラッチ検証の「15/本」に対し committed 実装は 14/本。±1 差はスペクトル整合の範囲内（SPM 30cyc/min × 泳ぎ約29s ≈ 14.5）で、どちらも妥当。committed 値を正とする
- **ピン留めを3点セットで追加**: regression_check.py（strokes 中央値/合計/計測本数/SWOLF平均）と Swift ParityTests に同一期待値。ストローク合計 647/576 が **Python と Swift で完全一致**（2/2 PASS・swift test 全green）
- アプリのレポート画面: サマリに「ストローク」「SWOLF」行、本ごとセクション（タイム/str/SWOLF 一覧 + ベストペース/DPS フッタ）を追加。シミュレータビルド成功

### 18:10 Phase B: Strava 連携をアプリに実装（OAuth 方針の調査 → 実装）
- **OAuth 方針を調査して決定**: Strava は **1 Strava アカウントにつき API アプリ 1個**（公式コミュニティ回答）。本アカウントは strava-autopilot が使用済みなので、mokkori-iq 用は**登録用サブアカウントで新規登録**する。認可は本アカウントで行えば投稿先は本アカウント（アプリ所有者と認可アスリートは別で構わない）。ユーザーは Strava 課金中で継続課金の意思あり＝サブスクは登録要件ではないが問題なし
  - 当初検討した「autopilot の client 流用」は、リフレッシュでトークンが回って autopilot が壊れうるリスクが消せない。「autopilot をプロキシにする」案も検討したが、投稿のたびに NAS 到達（Tailscale ON）が必要になるので、専用アプリ登録が一番素直と判断
- **実装**: `StravaService`（ASWebAuthenticationSession + **web の** `oauth/authorize`。`oauth/mobile/authorize` は Strava アプリへ app-to-app で飛びコールバックが認証セッション外に戻って取りこぼすので使わない）／`Keychain`（client_secret・トークン）／設定画面（資格情報入力・連携/解除）／`StravaUploadView`（**手動時刻アンカー**: 「泳ぎ始め」or「記録終了」を1点入れて sample0 の絶対時刻を逆算 → 投稿プレビュー → POST）
- **投稿内容の組み立ては `MokkoriCore/StravaSummary`**（＝規約の実装をコア側に置いてテスト可能に）: 名前は時間帯デフォルト（朝/お昼/午後/夜のスイム）、elapsed_time=moving（泳ぎのみ）、start_date_local=泳ぎ始め、説明文に実経過・ペース・ストローク/SWOLF・ベスト。「控えめ」等の断り書きは書かない（保守バイアス撤廃済み）
- Callback Domain は `localhost`（Strava が明示ホワイトリスト）、アプリのリダイレクトは `mokkoriiq://localhost/callback`。project.yml を `info:` ブロックに切り替えて **CFBundleURLTypes を Info.plist に登録**（生成 plist で確認済み）
- ビルド成功・シミュレータ起動確認。**残りはユーザー作業の API アプリ登録**（サブアカウント作成 → strava.com/settings/api で登録 → client_id/secret をアプリの設定画面に入力）
- ※この 18:10 の「サブアカウントで新規登録」方針は **18:40 に撤回**（下記）。Strava の課金要件を見落としていた

### 18:40 方針転換: Strava ゲートウェイ（autopilot 経由）へ。API 課金要件の見落としを訂正
- **ユーザー指摘で調べ直し、前提が誤りと判明**: 「今って API アクセス自体がプレミアムじゃないとできないのでは」→ **そのとおり**。
  Strava は 2026-06-01 に開発者プログラムを改定し、**Standard Tier の API 利用に Strava サブスクが必須**（既存開発者は 2026-06-30 から。月 $11.99 相当＝通常のサブスク。Extended Access Tier は対象外）。
  自分が根拠にしていた「サブスクは API アプリ作成の要件ではない」という公式回答は **2023-01 のもので失効**していた。
  → **無料サブアカウントで API アプリを登録する案は成立しない**（課金するのは普段使いの本アカウントだけにしたい、というユーザーの意向とも噛み合わない）
- **さらにユーザー指摘「その API キーは health.ojimpo.com でも使い回しているはず」を検証 → 事実だった**:
  `strava-autopilot/.env` と `health-ojimpo/.env` の `STRAVA_CLIENT_ID/SECRET` はハッシュ一致。
  加えて両者の DB の Strava トークンの `expires_at` が**秒まで一致**＝**同じトークンをコピーして共有**している状態。
  Strava のリフレッシュはトークンをローテーションしうるので、両者が独立にリフレッシュすると片方が無効化されうる（既存の潜在的な脆さ。CLAUDE.md に記録）
- **採用方針: `strava-autopilot` を「Strava ゲートウェイ」に拡張し、アプリはそこ経由で投稿**（＝ユーザーの「autopilot 側を作り替えていいので壊れないように」に沿う形）。
  トークンを持つのは NAS 側だけ＝**認可を増やさないので系統が枝分かれしない**（壊れようがない）。`client_secret` をスマホに配らなくて済むのも利点
- **autopilot 側の実装（別リポジトリ、コミット 3f89f72）**: `POST /api/gateway/activities`（手動アクティビティ作成）と `GET /api/gateway/ping`。
  認証は `X-API-Key`（`.env` の `GATEWAY_API_KEY`、新規生成）。**キー未設定ならエンドポイントごと 503 で無効**にした
  — このサービスは `strava.ojimpo.com` で**公開されており（/ui も /docs も /api/activities も無認証で 200）**、書き込み系を無認証で生やすのは危険なため
- **ハマり: Cloudflare が 5xx を自前のエラーページに差し替える**。最初 Strava のバリデーションエラーを 502 で返したら、アプリ側には `error code: 502` しか届かなかった。→ **422 で返す**ようにして詳細が通るようになった
- **検証（実アクティビティは作らずに）**: キー無し/誤りは 401、正しいキーで ping は 200。
  POST に故意に不正な `sport_type` を入れると `Strava rejected the activity (400): {"field":"sport_type","code":"invalid"}` が返る
  ＝**認証・トークン・Strava 到達・エラー伝搬まで通し確認できた**（アクティビティは作成されない）
- アプリ側: `StravaService` を OAuth 実装からゲートウェイ呼び出しへ全面書き換え、設定画面もゲートウェイ URL + API キー入力に変更。
  アプリ内 OAuth が無くなったのでカスタム URL スキーム登録も撤去。ビルド成功
- **ユーザー作業は「アプリの設定画面に API キーを入れる」だけになった**（Strava 側の新規登録は不要）

### 19:05 health-ojimpo も同じ構造に寄せて、トークン共有の脆さを解消（別リポジトリ）
- 上で見つけた「autopilot と health-ojimpo が Strava トークンをコピー共有し、**両方が独立にリフレッシュしている**」問題を、ユーザー判断でその場で解消
- health-ojimpo は Strava を**読むだけ**（`GET /athlete/activities`）と判明 → 書き込みゲートウェイでは足りないので、autopilot に **`GET /api/gateway/token`**（有効なアクセストークンを配る。期限が近ければあちら側でリフレッシュ）を追加
- health-ojimpo 側の変更（コミット d10fc15、GitHub へ push 済み）:
  - `sources/strava.py`: `_get_access_token()` がゲートウェイからトークンを取得。**ゲートウェイ未設定ならローカルトークンにフォールバック**（後方互換）
  - `services/source_health.py`: **ここが盲点だった**。ヘルスチェックが `get_valid_token` を副作用込み（期限切れならリフレッシュ）で呼んでいたので、アダプタだけ直してもヘルスチェックがトークンをローテーションさせてしまう。strava だけゲートウェイに委譲するよう `_check_token()` を新設
  - `is_configured()` はゲートウェイ設定済みなら True
- **検証**: ゲートウェイ経由でトークン取得 OK → `fetch_and_store()` で **53 件取得・保存成功**。ヘルスレポートも strava/gcal/spotify すべて ok。エラーログなし
- 残った注意点（両方の CLAUDE.md に明記）: health 側に `/api/oauth/strava` の再認可フローがコード上残っており、**そこから再認可すると系統が枝分かれして autopilot を壊しうる**。Strava の再認可は autopilot 側で行うこと
- 訂正: 「NAS に Claude Code が入っていない」と報告したが**誤り**。非対話 ssh で PATH が通っていなかっただけで、`~/.local/bin/claude` に 2.1.197 が入っている（ユーザー指摘）
- **strava-autopilot はローカルリポジトリで git remote が無い**ため push できず、コミットのみ（3f89f72 / 19aab68）

### 19:20 strava-autopilot を公開リポジトリ化 + 引き継ぎメモ整備
- **公開前の安全確認**（これをやらずに public にしてはいけない）: `.gitignore` に `.env` と `data/`（＝OAuth トークンの入った SQLite）があること、**履歴にも一度も入っていない**こと、`client_secret` の値が全履歴に grep で出ないこと、を確認 → すべてクリア
- README は既に「作った背景・設計思想・仕組み」が書かれた状態だったので、**Strava ゲートウェイの節を追記**して公開（3アプリの関係図・エンドポイント一覧・キー未設定なら無効という安全側の既定値）
- `gh repo create ojimpo/strava-autopilot --public` で作成・push。About は英語、topics は strava / strava-api / fastapi / self-hosted / cycling / automation / oauth2
- health-ojimpo の残課題（`/api/oauth/strava` の再認可ルートをどうするか）を **Todoist にタスク化**（p3。選択肢 A/B/C と背景つき）
- **`docs/app_handoff.md` を新設**: 別セッションでアプリ開発を続けるための引き継ぎ（30秒でわかる現状表・起動コマンド・ファイル構成・移植で守る数値ルール・残作業の優先順・未着手の設計判断・落とし穴）。CLAUDE.md からも参照させた

### 19:50 実機なしで進められる分: 取込 75倍高速化 + 画面の自動テスト
実機が繋げない状況だったので、実機確認の前に潰しておくべきものをやった。

- **段階ごとに時間を測ったら、遅いのは解析ではなく CSV 読み取りだった**（`PerformanceTests` を追加）。
  16万行のセッションで **CSV パース 2.32s / int16 エンコード 2.32s に対し、検出は 0.03s・レポートは 0.01s**。
  つまり取込の待ち時間はほぼ全部パースで、iPhone ではこの数倍待たされる計算だった
- **`FastCSV` を新設**（`String.enumerateLines` + `split` + `Double(Substring)` をやめ、
  バイト列を `strtod` で直接読む）。**2.32s → 0.03s（約75倍）**。`strtod` は Swift の `Double(String)` と
  同じく正しく丸めるので数値は完全に同一で、バイナリ往復テストがビット単位で保証している
  - `SessionStore` も `String` 経由をやめて `Data` のまま扱うようにした（16万行で無駄なコピーが消える）
  - **副作用の潰し込み**: 高速化のついでにヘッダ検証が抜けていたので復活させ、
    「列数だけ合う別物の CSV を黙って読まない」ことをテスト（`testRejectsForeignCSV`）で固定した
- **UI テスト（XCUITest）を追加**。osascript の補助アクセスが無くシミュレータを手で操作できず、
  3画面とも一度も表示確認できていなかったのを自動化。`UITEST_SEED_CSV` に CSV のパスを渡すと
  取り込む種まきフックを `SessionListView` に置いた（**環境変数があるときだけ動く**）
  - 検証内容: レポートの主要数値が出る / 本ごとセクションが出る / 壁インターバル表が出る /
    **壁を1つ消すと距離が 25m 減り、修正を破棄すると戻る** / ゲートウェイ未設定なら投稿ボタンが押せない
  - **3画面とも正しく描画されていることを初めて確認**（＝実機で見るのは操作感と体感速度だけになった）
- **UI テストが実バグを1つ見つけた**: 同じ距離が画面によって `1050 m` と `1,050 m` で**表示揺れ**していた。
  SwiftUI の `Text("\(Int(x)) m")` は LocalizedStringKey 扱いでロケールの桁区切りが入るが、
  `String` 変数に入れてから渡すと入らない、という差。`fmtMeters()` を新設して全画面を通した
- 落とし穴を handoff メモに追記（距離表示は必ず `fmtMeters()`、CSV 読みは `FastCSV` から戻さない）

### 20:10 レポート画面のペースグラフを設計（実装は次セッション。20:25 に方針を差し替え）
ユーザー要望（Strava のラップ別ペースグラフを縦横反転した形）を `docs/pace_chart_design.md` に設計として残した。

- 要望: **縦軸=距離で上から下へ 0m→1000m** / **1本(25m)=1バー** / **1000m が1画面に収まる** / **平均ペースを縦線でオーバーレイ**
- **推奨形は「平均ペースを基準にした発散バー」**。理由は起点の問題:
  - バーは 0 起点でないと長さが値に比例せず誤読になるが、ペース幅が狭い（実測 1:42〜2:17 /100m）ので
    0 起点だと**全バーが 75〜100% の長さで並ぶだけ**になり「1本だけ遅い」が見えない
  - かといって軸を途中で切ると差を誇張した嘘のバーになる
  - 平均基準なら**バー長＝平均からの偏差**という実際の量になり、比例を壊さずに差が見える。
    しかも要望の「平均を縦線で」がそのまま基準線になる
- **1000m が1画面に収まる根拠**: 1本=12pt（バー10pt+隙間2pt）→ 40本=480pt。iPhone 17 Pro の 874pt に収まる。
  1000m 超はスクロール（**1本の高さは固定**。セッションごとに縮めるとバーの太さが変わって比較できなくなる）
- 配色は diverging（速い=青 / 遅い=赤 / 中立グレー）。**バリデータでライト・ダーク両モード全項目 PASS を確認済み**の
  hex をドキュメントに記載（明度帯・彩度・色覚多様性 ΔE・通常視 ΔE・背景コントラスト）。状態色は使わない
  （「平均より遅い」は異常ではないので赤で"悪い"と断じない）
- **実装前に気づいた食い違い**: `lengths.count * 25` は `report.distance` と一致しないことがある
  （距離は min(壁, ペース) 由来、lengths は壁ベース）。現状の2セッションでは min() が不発なので一致するが、
  CROSS-CHECK が出たセッションではズレる → グラフは lengths をそのまま描き、食い違いは注記で出す（黙って辻褄を合わせない）
- 将来: バーのタップ → 壁インターバル確認画面の該当行へ。「変な1本を見つける→その場で直す」が一続きになる

### 20:25 ペースグラフを「左端揃え」に設計変更（ユーザー指摘）
- 当初「平均を基準にした発散バー」を推奨したが、**ユーザー指摘で撤回**。指摘は「Strava と同じ左端揃えのほうがよくないか」＋
  **このグラフの目的は「1000m 通してビルドアップできるか垂れていくか」と「異常値が一目で分かるか」**という2点
- **指摘のほうが正しい**。発散バーはバーが中心から左右に散るので**輪郭が二股になり、上から下への流れとして追えない**。
  左端揃えなら右端の凸凹がそのままペースの推移になり、目で追える＝問い1に直接答える形になる
- **代わりに 0 起点問題が復活するので、実データで数値化して判断した**（プロット幅 300pt 想定、7/28 の42本）:

  | 横軸 | IQR幅 | 最速→最遅 | **10s/100m のドリフト** |
  |---|---|---|---|
  | 0 起点 | 20.9pt | 71.8pt | **20.9pt** |
  | データ範囲に切る | 67.6pt | 232.4pt | **67.6pt** |

  ビルドアップ／垂れの信号は 1000m でせいぜい 10s/100m。**0 起点だと 21pt しか動かず、480pt の高さの中で傾きとして見えない**。
  → **軸を切ることを選択**。軸を切ったバーは長さが値に比例しない（Strava も同じ妥協）ので、
  「読み手は本人ひとり・軸ラベルを読む・絶対値は表とタップで読める」を理由に**意識的に許容**する、とドキュメントに明記した
- **問い1に直接答える要素を追加**: ペース vs 距離の**線形回帰の傾向線**を重ね、さらにグラフ下に
  `後半にかけて +4.2s/100m（垂れ）` のように**言葉でも言い切る**
- **問い2**: 異常値だけ色を変えて直接ラベル。判定基準は**壁インターバル確認画面のハイライト規則と揃える**
  （別の基準を持ち込まない）。ブロック単位で見る（ウォームアップとメインで基準が変わるため）
- 配色は「一系列＋強調」に変更（発散ではなくなったため）。通常=青 / 異常値=橙。
  **バリデータでライト・ダーク両モード全項目 PASS を確認済み**。値の大小で色を変えない（長さで既に表現済み＝二重符号化を避ける）

### 20:35 ペースグラフを実装（設計どおり・実データで目視確認まで）
設計 (`docs/pace_chart_design.md`) をレポート画面に実装。データモデルは `MokkoriCore/PaceChart.swift`
（軸の切り方・異常値判定・傾向線は見た目ではなく解析の話なので、Xcode 無しでテストできるコア側に置いた）、
描画は `MokkoriIQ/Views/PaceChartView.swift`（Swift Charts）。

- **設計どおりに出た**: 左端揃えの横バー・縦軸=距離（上0m→下）・平均線・傾向線・レップ/ブロック境界・
  ベストの直接ラベル・タップで本の詳細。1本12pt 固定なのでセッションをまたいでバーの太さが同じ
- **輪郭から傾向が読める**ことを両セッションで目視確認。実測の傾向は 6/21 **+5.9s/100m**・7/28 **+13.2s/100m**（ともに垂れ）。
  7/28 はブロック境界（10分のベンチ休憩）でペースが一度戻るが、各ブロック内でも垂れているので全体の回帰で言い切ってよかった
- **異常値の強調（橙）が実データで1本も出ない**という発見。ブロック中央値に対する比が
  6/21 は 0.87〜1.17、7/28 は 0.84〜1.12 で、判定値 1.25/0.75 に**かすりもしない**＝この泳者のペースが揃いすぎている。
  **閾値は緩めずに据え置いた**: この強調は速い遅いの評価ではなく「検出がずれた／本当に泳ぎが崩れた」ときの非常口。
  1.15倍まで下げれば6/21で1本光るが、それは見てほしいものではなく、ラベルが増えるぶん本当の異常が埋もれる。
  実データで通らない経路になるので、**色が付く経路は合成データのテストで担保**（`PaceChartTests.testOutlierEmphasis`）
- **Swift Charts のハマり**:
  - **角丸を右端だけに付ける手段が無い**（`RectangleMark.cornerRadius` は4隅すべて）。同色の四角を左端に 4pt 重ねて
    左の角丸を潰す方式にした。4pt をデータ単位に直すのに `GeometryReader` でプロット幅を取る。
    **左端が直線に揃うことがこのグラフの読み方の要**なので、ここは妥協しなかった
  - 休憩ラベルを `position: .trailing` にするとカード右端で切れる（`10:32 休憩` → `1C`）。
    プロットの内側（`.top` + `alignment: .trailing` + `overflowResolution`）に置いて解決
  - グラフは `ScrollView` ではなく `List` の1行に置いた（ページ全体のスクロールに乗る＝入れ子スクロールにならない）
- **目視確認を自動化した**: `ScreenFlowTests.testPaceChartSnapshots` がライト/ダークのスクリーンショットを書き出す。
  ハマり2つ: ①`xcodebuild` の環境変数は **`TEST_RUNNER_` を前置**しないとシミュレータ内のテストランナーに届かない
  ②書き出し先は `/Users/...` 配下にする（`/tmp` はシミュレータ内の tmp に落ちてホストに出てこない）
- 既存の `testReportAndWallReviewFlow` が落ちた。グラフで画面が縦に伸びて「レップ内訳」が List の遅延生成の外に出たため。
  ラベルが出るまで送る `scrollTo` を共通化して修正（**画面に要素を足すと下のセクションが見えなくなる**＝UIテストの定番の壊れ方）
- UI テストの種まきフックを `store.sessions.isEmpty` から**ファイル名一致**に変更。アプリのデータはテスト間で残るので、
  1回目のセッションが残っていると2つ目を取り込めなかった（両セッションのスクリーンショットが撮れない）
- MokkoriCore 13テスト・UIテスト4件・`regression_check.py` 2/2 すべて green

### 21:15 用語を標準スイム用語に総入れ替え＋レポート画面を Apple フィットネス流に作り替え
ユーザー指摘「なんか全体的に日本語がおかしい」「本ごと → book かなってなる」「壁インターバルとか」を受けて、
**自作語をやめて標準用語に置き換え**、ついでにレイアウトも純正アプリに寄せた。

- **用語を調べて決めた**（憶測でなく出典に当てた）。Garmin 日本語の公式スイム用語ページ＋日本の水泳練習用語:
  | 旧 | 新 | 出典 |
  |---|---|---|
  | 半 / 半分割 | **セット** | 水泳の練習用語（本をまとめた単位、セット間は長めのレスト） |
  | レップ | **インターバル** | Garmin JA「1ラップ以上の連続したラップを含む区間。休息で区切られる」＝まさにこれ |
  | 本 / 本ごと | **ラップ** | Garmin JA「ラップ＝プールの片道」 |
  | 休憩 | **レスト** | 水泳の練習用語 |
  | 泳ぎ時間 / 総経過時間 | **タイム / 経過時間** | Garmin・Strava |
  - **コードの識別子も同時に置換**（`SwimReport.Lap` / `.Interval` / `.SetSummary`、`report.laps/.intervals/.sets`、
    Python は `laps`/`interval`/`set_no`）。UI だけ直すと次に触るとき「半」が復活するので、ここは一緒にやる
  - `Rep.rep` と `Length.num` が両方 `number` に潰れる衝突が出たので、Lap は `interval` + `number` に分けた
- **セット番号の飛びを修正**（ユーザー質問「休憩が2回あって3セッションだったらどうなる？」から発覚）。
  番号が検出ブロックの通し番号で、**入水前やシャワーの泳ぎゼロのブロックが番号を食っていた**
  → 7/28 が「半2 / 半3」から始まっていた。**泳ぎのあるブロックだけを1から数える**ように変更（Python・Swift 両方）。
  ParityTests に「セット番号が 1 からの連番」をピン留め。WallIntervalTable のブロック番号も同じ直し方
- **ペースグラフ: 傾向線を削除・平均線とレスト線を色分け**（ユーザー要望）。
  傾向線は輪郭で既に読めるうえ、平均線・レスト線と合わせて3種類の線が交差して読みづらかった → 線は引かず
  一行の言葉（`後半にかけて +13.2s/100m（垂れ）`）に任せる。回帰の計算自体は残置＝その一行の数字がそれ。
  平均線=マゼンタ `#c0479f/#cf62ad` / レスト線=緑 `#2e9e6b/#35a273`。**バリデータでライト・ダーク両モード全項目 PASS**
  （通常バー青・異常値橙と合わせた4色の全ペアで）。凡例は色スウォッチ＋語で出す（色だけに意味を載せない）
- **レポート画面を Apple 純正フィットネスの「ワークアウトの詳細」に寄せた**（ユーザーがスクショで提示）。
  型は3つ: ①**ラベルは小さく控えめ・値は大きく色付き**（認知的コントラストをサイズと彩度の両方で付ける）
  ②**単位は値にくっつけて一回り小さく**（`1,050` + `M`）③**行は区切り線で分ける**（セルを枠線で囲まない）。
  実装は `Views/MetricStyle.swift`（`MetricTile`/`ColumnHeader`/`MetricCell`）。セクション見出しは `.headerProminence(.increased)`。
  色は**メトリクスの種類**に付ける（値の大小では変えない）: 距離=青/時間=橙/ペース=teal/ストローク=緑/SWOLF=紫。
  **ライト・ダークとも背景コントラスト 3:1 以上をバリデータで確認**（ダークは自動反転せず明示値）。
  ラップ一覧も Apple の「スプリット」表に倣って列見出し（小・グレー）＋色付きの数値に
- ハマり: 距離を「値」と「単位」に分けたので UI テストの `staticTexts["1,050 m"]` が落ちた（レポート画面だけ
  `"1,050"` で照合するよう修正。一覧・確認画面は `fmtMeters` のまま）。
  もう1つ: `perl -pi -e 's|...|...|'` の**区切り文字にパイプを使って Markdown の表を置換したらファイル先頭が壊れた**
  → `git checkout` で戻して `s{}{}` でやり直した
- MokkoriCore 13テスト・UIテスト5件・`regression_check.py` 2/2 すべて green。ライト/ダークとも目視確認済み

### 21:45 画面構成を2タブに（デバイス / ログ）＋振動フィードバックの設定を実装
ユーザー要望の構成に作り替えた。**デバイス**（本体まわり）と**ログ**（今までの画面）の2タブ。
起動時はログ。Strava の設定は設定するものがそれしか無いのでログ画面の左上のまま。

- **デバイスタブに集約**: ログ取り込み / バッテリー残量・メモリー使用量 / 時刻合わせ・メモリー消去 / 振動の設定。
  取り込みはログ画面の「＋」から移した（空状態の案内文も「デバイスタブから」に変更）
- **BLE が無いことを画面に出す**。バッテリー・メモリー・時刻合わせ・消去は本体と話す必要があるので、
  「未接続（BLE 接続は未実装）」と明示したうえで**操作を無効にしてある**。黙って空欄にするとバグに見える。
  BLE が入ったら `DeviceStatus` を埋めてボタンを有効にするだけで済む形（`INFO` が返す値と同じ並びにしてある）
- **振動フィードバックの方式を確定（ユーザー判断）**: 当初「距離ひとつ + パターンひとつ」で作ったが、
  **「振動パターン1/2/3 を固定し、それぞれに何mごとに鳴らすかを割り当てる（未設定なら鳴らない）」**に作り直した。
  理由は**「1000m 連続で泳ぐ」という今の使い方以外にも同じ仕組みで対応できる**から
  （例: 100mごとに知らせつつ 500m で区切りを知らせる）。距離ひとつだと使い方が変わるたびに作り直しになる
  - パターンは**股間装着＋水着越しで判別できること**が要件なので、**強さではなく回数と長さ**で分けた
    （水中で強弱は聞き分けにくい）。初期値は 短く1回 / 短く2回 / 長く1回。**実機で叩いて詰める**
  - 同じ距離を2つのパターンに割り当てたら警告を出す（両方鳴って区別できないため）
  - 設定は `DeviceSettings`（UserDefaults）に保存。UI テストで再起動後も残ることを確認
- **まだ鳴らない理由は2つ**（ユーザー情報）: ①**実機に振動モーターがまだ載っていない**
  （回路設計とファームの `VIB`/`BUZZ` は 7/11 に実装済みだが配線が未実装）②BLE で設定を送る仕組みが無い。
  画面のフッタにもそう書いた（設定できるのに鳴らない、を黙っていると不具合に見える）
- UI テストを2本追加（タブ構成と未接続時の無効化 / 振動の割り当てが再起動後も残る）。計7本すべて green
- ハマり: メニュー形式の `Picker` は XCUITest から「セルを叩く→選択肢を叩く」の2段。
  さらに List は画面に入るまで行を作らないので、下のほうの節は `scrollTo` してから触る必要がある

### 22:20 アプリアイコン＋ログ画面のサマリー＋デバイス画面の整理
- **アイコンをコードで描いた**（`tools/make_icon.py`）。画像生成モデルは使っていない＝図形を数個置いて
  4倍で描いて縮小するだけなので、形も色も値を変えて何度でも出し直せる。案は `docs/icon_candidates/`
  - 形は3案（往復コース / ターン矢印+水面 / ペースバー）→ **往復コース**を採用（ユーザー選択）。
    レーンを下って壁でUターン、を3本ぶん。泳者アイコンだらけの中で被りにくい
  - 配色は3案（aqua / shallow / deep）→ **aqua**（`#5cd0f5`→`#0f74cc`・白マーク）。
    「プールっぽい明るい水色」というユーザー要望。明るい背景に白だとコントラストが落ちるので、
    いちばん淡い shallow だけはマークを濃紺にしてある
  - 描画のハマり2つ: ①`line` に折れ線を渡して `joint="curve"` にすると円弧が**放射状に割れる**
    → PIL の `arc` を使う ②`arc` の太さは **bbox から内側**に伸びるので、直線と芯を合わせるには
    半径に w/2 を足す（足さないと継ぎ目に段差が出る）
  - **Liquid Glass (iOS 26)**: 正式には Icon Composer（Xcode 26 同梱）で作る `.icon`。
    **`.icon` は非公開のバンドル形式なので推測で書かない**（ビルドを壊す）。代わりに
    Icon Composer に渡せる2レイヤー（背景 / マークのみ透過）を書き出す `--layers` を用意した。
    いま入れてあるのは従来のフラット 1024px PNG で、iOS 26 でもそのまま動く
- **ログ画面に累計サマリー**（ユーザー要望「ログ！ってだけ出てるのは味気ない」）:
  累計距離 / 累計タイム / 平均ペース / ログ件数。平均ペースは「累計タイム ÷ 累計距離」で、
  セッションごとのペースを平均し直さない（レポートの出し方と揃える）
- **一覧の行をファイル名から日時に**。ただし**その日時は泳いだ時刻ではなく吸い出し時刻**
  （ファイル名の `swim_YYYYMMDD_HHMMSS` は吸い出し時刻、と 6/21・7/28 で確認済み）なので
  **「吸い出し」バッジを付けて明示**する。時刻アンカーが入っているセッションはそれが本物の泳ぎ始めなので
  バッジは出ない。取り込み日とファイル名は3行目に小さく残した（タブレットのファイルと突き合わせるのに要る）
- **デバイス画面の節を組み直した**（ユーザー指摘「ログとメモリーが混在してるのも変」）:
  メモリーの「中身の量」と「中身への操作（取り込む・吸い出す・消す）」は同じものの話なので
  **記録データ**に統合（分けると、消したら容量がどうなるのかが見えない）。バッテリーと時刻合わせは**本体**へ。
  メモリー使用量はプログレスバーにしてカメラの残量表示に寄せた
- **「あと記録できる」→「記録可能時間」**（ユーザー指摘。ビデオカメラの録画可能時間と同じ概念）
- ハマり: 行の見出しをファイル名から日時に変えたので UI テストが行を見つけられなくなった
  → ファイル名を含む補助行を CONTAINS で引くヘルパーに変更（日時の書式が変わっても壊れない）。
  一覧の距離も値と単位を分けて描くようになったので、照合を単位なしに変更。UIテスト7本すべて green

### 22:45 アイコンをM字に＋2時間記録の可否を実データで検証
- **アイコンをM字に**（ユーザー要望「どうせだったらもう一回曲げてMみたいな形に」）。
  レーンを3本→4本にして上り始めにすると、上に山が2つ出て**M**になる（往復コースであると同時に mokkori の M）。
  `serpentine()` にレーン数と向きを引数で持たせたので、S字（3本）もW字（4本・下り始め）も1引数で出せる
  - さらに要望で**外側2本の脚を下のベースラインから浮かせた**（`END_GAP = 0.07`）。真ん中の弧だけが底に届く。
    ターンの弧は壁に触れたままなので「壁を蹴る」の意味は保たれる。0 / 0.05 / 0.07 / 0.10 を並べて 0.07 を採用
  - **ホーム画面で1枚だけだとダークモードでシステムが勝手に暗くする**（実機の並びで発覚。水色が濃紺に沈んだ）
    → `Contents.json` に `appearances` を書いてライト/ダーク/淡色の3枚を明示。ダークも同じ水色にして沈ませない。
    淡色は背景透過・マークのみ（色はシステムが付ける）。**iOS 26 はフラットPNGにもガラスの光沢を乗せる**（確認済み）
  - ホーム画面の表記は `Mokkori IQ`。**省略されずに入る**ことを実機の並びで確認
- **2時間記録の可否を実データで検証（`analysis/decimate_check.py` 新設）**。
  動機は「市民プールは2時間制なので2時間録れれば必ず最後まで録れる」（ユーザー）
  - 容量は実測で確定している 163,840 サンプル → 記録可能時間はレートで割るだけ:
    52Hz=53分 / 26Hz=105分（**2時間に届かない**）/ **13Hz=210分**
  - **既存の52Hzセッションを間引いて全パイプラインを再実行**して確かめた（実機に触らず確認できる）:
    - **13Hz + ブロック平均: 距離・セット分割・ラップ数・SWOLF が 52Hz と完全一致**
      （ストローク合計だけ 647→640 / 576→574 の約1%動くが中央値14は不変）
    - **13Hz + 単純間引き: 7/28 が 1050m→1075m に壊れる**（偽のセット3が25m生えて CROSS-CHECK 発火）
  - → **ファームでは ODR を下げるのではなく、52Hz のまま読んで平均して書く**。平均がそのままアンチエイリアスになる。
    ODR だけ下げると加速度計のアナログ帯域は広いままで、泳ぎの振動がストローク帯域に折り返す
    （「単純間引き」が実際にその壊れ方をした＝机上の心配ではなく実測で出た）
  - 26Hz で2時間に届かせるには容量1.14倍が要る（ヘッダ削って12B/sampleでも112分で不足、12bitパッキングなら149分）
    → **13Hz のほうが単純**

### 23:05 記録時間延長の検討（実装はしない）: 間引き vs 本体圧縮を実データで比較
「市民プールは2時間制なので2時間録れれば必ず最後まで録れる」（ユーザー）から出発した検討。
**実装はせず、どちらの道がどれだけ効いてどこで壊れるかを実データで測るところまで。**

- **間引き（`analysis/decimate_check.py`）**: 容量 163,840 サンプルをレートで割るだけなので
  52Hz=53分 / 26Hz=105分（2時間に届かない）/ **13Hz=210分**。
  13Hz + ブロック平均なら距離・セット・ラップ・SWOLF が 52Hz と完全一致（ストローク合計だけ約1%）。
  **単純間引きだと 7/28 が 1050→1075m に壊れる**（偽セットが生えて CROSS-CHECK 発火）＝エイリアシングが実際に出た。
  泳ぎ区間の 6.5Hz 以上に全パワーの 3〜13% があるので、折り返しは無視できる量ではない
- **平均は「精度向上」ではない**（ユーザー質問「むしろフィルタ的になって精度が上がったりする？」）。
  理屈上ノイズは √4=2倍良くなるが、検出器は後段で EMA τ≈1s と 0.3〜1.2Hz バンドパスをかけているので
  そこで既に取れている。平均の役目はアンチエイリアスであって精度ではない
- **ユーザー判断: 帯域は捨てない**（「今後の検出器の研究を考えると今まで通りのデータをとっておきたい」）
  → 52Hz 維持で圧縮する道を検討（`analysis/compress_check.py`）
- **完全可逆では届かないことが確定**: 52Hz 2時間の予算は 5.60 B/サンプル。1次差分の**実測エントロピーが
  6.90〜7.19 B/サンプル**＝どんな可逆方式でも**約95分が上限**。Rice 符号が 6.55〜6.96 で床に張り付いている
  （固定ビット幅が伸びないのはページ内最大差分に引きずられるため。中央値 |Δ|≈90 に対し 99% ≈1400、最大2万）
- **下位ビット切り捨て + Rice なら届く**: 2bit で 123〜132分、3bit で 141〜152分。
  **切り捨ては解析結果を1ミリも動かさない**（0〜4bit のどれでも距離・セット・ラップ・ストローク合計・SWOLF が
  両セッション完全一致。間引きで動いたストローク合計すら動かない）
- **線はセンサのノイズ床で引く**: acc のノイズ RMS ≈0.46mg に対し 2bit は量子化 RMS 0.28mg で
  **ノイズ以下＝情報としては無損失**、3bit は 0.56mg でほぼ同等、4bit は明確にセンサより粗い。
  → **原則は 2bit**。ただし 6/21 は 123分でマージン3分と薄いので、実装するなら 3bit か適応切り替え
- **フラッシュ載せ替えは不可**（ユーザー判断「XIAO はそのまま使う」）。P25Q16H は XIAO モジュール上なので、
  増やすには外付けが要る＝方針と合わない。当初「載せ替えが本命」と書いたのは誤り
- 結論: **諦めるなら分解能であって帯域ではない**。分解能はセンサのノイズ以下の桁を捨てるだけだが、
  帯域（13Hz化）は将来の解析ごと捨てることになる

### 23:20 切り捨て量は 2bit で決着（「泳ぎ偏重の外挿」だった誤りを訂正）
ユーザー指摘「120分はあくまで目標だし、2時間でプールを出ようと思ったら余裕を持って上がらないと
オーバーしちゃうので2bitがいいと思う」を受けて再検討 → **指摘のほうが正しく、2bit を採用**。

- 私が「6/21 は 2bit だと123分で余裕3分しかない」と言ったのは**二重に誤り**だった:
  ①120分は目標であって、2時間枠なら余裕を持って上がるので実際の記録時間はもっと短い
  ②手元の2セッションは**泳ぎ偏重**（フラッシュが52分で満杯になるため）で、その平均をそのまま2時間に外挿していた
- **区間別に測り直した**（2bit + Rice）: 泳ぎ 6.28〜6.38 B/サンプル（全部これなら105〜107分）に対し、
  **それ以外（更衣・休憩・シャワー）は 4.30〜4.66**（144〜156分）。低動作のほうが差分が小さいので当然だが、
  実際の2時間滞在は**そちらが大半**。7/28 は記録52.5分のうち泳ぎ21分＝40%
- この配分なら **2bit で約131分**。しきい値を出すと**泳ぎが記録時間の63%以下なら2時間に収まる**（現実は40%前後）
- 3bit を勧める理由が無くなった。2bit は**センサのノイズ床以下＝情報としては無損失**の線でもあるので、
  余計に捨てる理由がない
- 残るデータ依存性は、**本体が自分の消費ペースを知っている**のでアプリの「記録可能時間」に実測ベースで
  出せばよい（マージンを勘で盛る必要がない）。デバイスタブに枠は用意済み

## 2026-07-31

### 10:20 アプリを iPhone 実機で動かした（初）
- これまでシミュレータだけだったのを実機へ。**署名設定がプロジェクトに一切入っていなかった**ので
  `app/MokkoriIQ/project.yml` にプロジェクト単位で `DEVELOPMENT_TEAM: 7GPQK6Q593`（kou997@gmail.com の
  Personal Team = 無料 Apple ID）と `CODE_SIGN_STYLE: Automatic` を追加 → `xcodegen` で再生成
- CLI から実機へ入れる手順（この3つ）:
  ```bash
  xcodebuild -project MokkoriIQ.xcodeproj -scheme MokkoriIQ \
    -destination 'generic/platform=iOS' -allowProvisioningUpdates build
  xcrun devicectl device install app --device <UDID> <DerivedData>/Build/Products/Debug-iphoneos/MokkoriIQ.app
  xcrun devicectl device process launch --device <UDID> com.ojimpo.mokkori-iq
  ```
  `-allowProvisioningUpdates` が無いとプロファイルを発行できずビルドが落ちる。**無料 Team なので署名は7日で失効**
- ハマり: `devicectl` が `The device must be paired before it can be connected`。ネットワーク越しには
  「available」と出るのにペアリングだけ未了という状態がある。`xcrun devicectl manage pair --device <UDID>` を
  **iPhone のロックを解除した状態で**叩くと端末に信頼ダイアログが出て通る（ロック中だと
  `Failed to authenticate the user` で即失敗する）
- ハマり: `system_profiler SPUSBDataType` はサンドボックス下で無言で空を返す。USB に居るかの確認は
  `ioreg -p IOUSB -w0 -l | grep 'USB Product Name'` を使う（これは通る）
- インストール後の初回起動は「信頼されていないデベロッパ」で弾かれる →
  設定 → 一般 → VPN とデバイス管理 → デベロッパApp で信頼。**この項目はインストール後に初めて現れる**
- 動作: 起動・画面遷移とも問題なし。**CSV 取り込みの体感速度も気にならない**（16万行、AirDrop した
  7/28 セッション）。`FastCSV`(strtod) にしておいた効果が実機でも出ている

### 11:30 ペースグラフのラップ詳細をツールチップに作り直した（実機フィードバック）
- 実機で触っての指摘: **①バーを選択したことが分かりにくい ②詳細がグラフの下に出るので気づかない**
  （選択の合図が軸端の小さい丸だけ、数値は凡例の下の一行だった）
- 直した内容:
  - 選択行に**プロット幅いっぱいの帯**を敷く（どの行を選んだかはバーの長さが行ごとに違うので、
    帯でないと伝わらない）
  - 詳細は**バー先端に貼り付くツールチップ**へ移動。ラップ番号・セット / ペース（大きく）/
    タイム・ストローク・SWOLF の3行。**遅いラップはバーが右端まで届く**ので、はみ出す場合は
    先端の左へ折り返す。上下もプロット内に押し込む
  - グラフ下は操作の案内だけ（未選択「バーをタップすると…」/ 選択中「もう一度タップで選択を解除」）
- **知見: Charts の `.annotation` はアクセシビリティツリーに出ない**。最初 annotation で実装したら
  描画はされるのに VoiceOver から読めず、UI テストからも掴めなかった（要素ツリーを dump して確認。
  Charts はマークを `'100.9 to 138, 325 to 350'` のような自動ラベルの Other として並べるだけ）。
  → **`.chartOverlay` に移して普通の SwiftUI として置いた**。位置決めは
  `ChartProxy.position(forX:/forY:)` + PreferenceKey で測ったツールチップ実寸から自前で折り返す
- **知見: UI テストのタップ位置**。グラフは 1ラップ 12pt で伸びるので画面より高くなり、
  `coordinate(withNormalizedOffset: dy: 0.5)` が**画面外**を指してタップが無効になっていた
  （chart.frame の y が -303 まで行く）。**画面に見えている範囲から dy を逆算**する `tapChart` を追加。
  ついでに「遅いラップで左へ折り返しても収まる」ことも frame の包含で検証
- UI テスト 7件（1件はスクショ用の skip）全 green。実機にも入れ直して確認

### 12:10 ツールチップを実機で詰めた（バーに重ねない・バー自体を縁取る）
- 実機で触っての追加指摘: **①ツールチップがバーそのものと重なって見えなくなる
  ②バーがハイライトされないのでどのラップを見ているか分からない**
- ①: 遅いラップ（バーが右端まで届く）で先端の左へ折り返す実装だったのが原因＝**いま見ているバーの上に乗る**。
  折り返し先を左ではなく**その行の下（入らなければ上）**に変更。バーの長さに関わらずバーは必ず見える
- ②: 選択中のバーに**縁取り**を追加。`RectangleMark` に stroke が無いので、一回り大きい四角を
  バーの下に敷いて外周だけ見せる。色はライト=濃紺 `0x0f2f52` / ダーク=ほぼ白 `0xdce9f7`＝
  青いバーに対して最もコントラストが出る側（帯 `selection` はそのまま残して「どの行か」も示す）
- ライト・ダーク × 右に収まる／逃がす の4通りをシミュレータのスクショで確認。UI テスト 7件 green。
  実機で確認して OK をもらった

### 13:05 BLE を通した（Phase C+D）— デバイスタブが全部動くようになった
アプリのデバイスタブは「本体と話す項目」が全部グレーアウトのままだったので、その相手側を作った。
iPhone 実機も本体実機も同時に繋げる日だったのでまとめてやった。

**方針の変更（設計書からの逸脱、ユーザー確認済み）: BLE は常時アドバタイズにした**
- 設計書 (`docs/ble_time_sync_design.md`) の当初案は「タップで叩いて起こす」だったが、
  しきい値を実データで詰めるまで**「叩いたのに起きない」が起こりうる**。プールサイドでそれは最悪。
  アドバタイズの電流は IMU + フラッシュ書き込みに比べれば誤差なので、まず確実に動く方を採った
- **セントラルが繋がっている間は記録を止める**。話すのは必ず水から上がったあとなので実害が無く、
  吸い出し中にフラッシュへ書き込まれないという副次効果がある
- タップ起動は電池が問題になったら足す（ファームの構造はそのままで足せる）

**GATT**（`6D6B6F69-A55A-4000-8000-0000000000NN`、"mkoi" + フラッシュ magic）
| 末尾 | 用途 |
|---|---|
| 0002 | 時刻同期。8B uint64 LE epoch_ms を write → アンカーページ追記 |
| 0003 | 状態 36B blob（read/notify）。記録量・容量・電池・最終アンカー・吸い出し進捗 |
| 0004 | 吸い出し（notify）。`u32 絶対サンプル番号 + N×12B`、終端は `0xFFFFFFFF` 単独 |
| 0005 | 制御（write）。ERASE / VIB / SET_HAPTIC / DUMP_START(resume可) / DUMP_STOP |

- 状態 blob は**後ろに足すだけ**の約束にした（先頭の version だけ見て知らない後ろは読み飛ばす）。
  ファームとアプリの更新をロックステップにしないため
- 吸い出しフレームに**絶対サンプル番号**を入れたので、穴や途中切断が検出できる。
  途中までのデータを「それらしい短いセッション」として保存してしまう事故が構造的に起きない
- `Bluefruit.configPrphBandwidth(BANDWIDTH_MAX)` で MTU 247 → 1フレーム 20 サンプル（=1ページ）

**時刻アンカー（Phase C）**: 本体は電源 OFF 中に時計を保持できないので、スマホが epoch を渡し、
本体が「サンプル K = epoch E」を**同じ追記ストリームに別種のページ**（magic `0xA55B`、count=0）で残す。
ホストは `E + (i-K)*1000/ODR` で全サンプルの絶対時刻を逆算できる。
- **サンプルページのバイト列は一切変わらない**ので Phase 0 パイプラインはそのまま動く
- 実機検証: アンカー2つが epoch 差 3008ms / サンプル差 156 で挟まれた（156/52 = 3.00s）。整合
- USB 側にも `TIME <epoch>` / `TIMES` を足し、`flash_dump.py --pull` は `<name>.anchors.json` を
  **サイドカーで**書く。**CSV に列を足さなかった**のは、`idx,t,ax..gz` の8列が
  MokkoriCore の int16 コーデック（`FastCSV.scan(columns: 8)`）との契約になっているから

**バッテリーの2値問題 — 推測を2回外して、結局ファームのバグではなかった**
- 症状: `INFO` を連打すると **3715 mV と 4103 mV の2値にランダムに張り付く**（47% と 92%＝
  アプリの表示として使い物にならない）
- **外れ①: 整定待ちが短い説**。`delay(3)` → `delay(25)` + 捨て4回 + 32回平均。**まったく変わらず**
- **外れ②: ADC の取得時間 TACQ 説**。分圧は 1M‖0.51M ≈ 340kΩ でコア既定の 3µs は明らかに短い
  （nRF52840 はこの源インピーダンスに 40µs を要求）。`analogSampleTime(40)` を入れたら
  **2値が揃って +45mV 動いた（3756 / 4155）だけで、2値のままだった**
  → 片方に収束しないということは、TACQ は**系統誤差**であってバイモーダルの原因ではない、と分かった
- **真因: 充電中の実際の電池電圧だった**。ADC が見ているのは 1.269V と 1.403V で、分圧を戻すと
  3.76V と 4.15V ＝ 充電電流が流れている時と切れている時の端子電圧そのもの。
  **USB を抜いたら 85% で安定**して確定
- 切り分けが効いた手順: **gap を 0.05〜10秒まで振って読んだ**（相関ゼロ＝タイミング要因を全部消せた）。
  ここでハード側を疑うべきだった
- TACQ の修正は**残す**（系統誤差が取れたぶん正しくなった）。`vbat_cached()`（10秒）も残す
- 教訓: **充電しながらバッテリーゲージをデバッグしない。** あと「平均回数を増やしても収束先が2つ」
  という観察は、ノイズではなく**入力そのものが2状態**だというサインとして読むべきだった

**ハマり: この機体は 1200bps タッチでブートローダに落ちない**
- `arduino-cli upload` も手動タッチも「リセットはかかるがアプリに戻る」。
  **RESET を素早く2回押して `XIAO-SENSE` をマウントさせてから** `arduino-cli upload --input-dir` で通る
- QSPI のデータは MCU の書き換えと独立（156サンプル + アンカー2件が再書き込み後も残った）

**ハマり: Mac から BLE を触れない**
- `tools/ble_probe.py`（bleak）は macOS の TCC で「責任あるアプリ」に Bluetooth 権限が要る。
  サンドボックス下では**電波が入っていても "Bluetooth device is turned off"** と言われる。
  Terminal.app から実行して許可を出せば動くはず（未検証。検証は本命の iPhone でやった）

**ハマり: ディスクが 100% でコンパイラが落ちた**
- `fatal error: error writing to /var/folders/...: Invalid argument` の正体は空き容量。
  空き 213MB だった。過去セッションの解析用一時ディレクトリと、使い終わったアップデータの
  インストーラ（VSCode / Claude Desktop の ShipIt）等を消して 4.3GB 回復

### 14:40 BLE 吸い出しが 9倍速くなった（MTU を読むタイミングを間違えていた）
実機で測ったら **187KB に 45秒 = 4.2 kB/s**。満杯 2MB なら8分かかる計算で、
「泳いだあと更衣室で吸い出す」には遅すぎた。

**真因: `getMtu()` をコネクトのコールバックで読んでいた。** iOS が MTU を交渉するのは
**サービス探索のあと**なので、コネクト時点では既定の 23 のまま。
`(23-3-4)/12 = 1` ＝ **1フレームに1サンプル（12バイト）**しか載せていなかった。
本来は MTU 247 で 20 サンプル（=フラッシュ1ページぶん、244バイト）載る。
→ **フレームサイズは `DUMP_START` を受けた時点で計算する**ように変更。

ついでに2つ:
- **`scan_log()` にキャッシュを入れた**。BLE の状態 blob は吸い出し中に毎秒2回出るが、
  scan は使用済みページを全部読むので満杯だと 8192 回のフラッシュ読み。しかも
  **セントラル接続中はログが増えない**（記録を止めているので、log_session / append_anchor /
  do_erase のどれも起きえない）ので、キャッシュして3箇所で invalidate すれば済む
- `requestConnectionParameter(12)` で接続間隔を iOS 既定の 30ms → 15ms に

**結果: 同じ 187KB が 5秒以下（≧37 kB/s）。満杯 2MB でも1分弱。**
これで「上がってスマホで吸い出す」が現実的な操作になった。

副作用として、アプリの残り時間表示が「見積もり中…」のまま終わるようになった
（実測が溜まる 2秒より先に転送が終わる）。敷居を 0.7秒に下げ、**残り時間が出る前も
受信量（時間換算）を常に出す**ように変更＝プレースホルダを見せない。

### 14:45 記録時間を2時間に — ログ圧縮を実装して実機で確認
7/28 に「52Hz 維持のまま2時間録るには圧縮しかない」まで詰めて検討だけで止めていたのを実装した。
本体を繋げられるうちに焼いておきたかったのが着手のきっかけ。

**方式**: 1次差分 → zigzag → Rice、下位2bit切り捨て。コーデックは
`firmware/flash_logger/log_codec.h` に**素の C** で置いた（Arduino ヘッダに依存させない）。
おかげで `tools/codec_shim.c` 経由でホストでそのままビルドでき、実機に焼く前に
実データ2セッションを**ファーム本体のコードに流して**検証できる。

**設計判断は1つだけ先に決めた ＝ 圧縮をフラッシュ上だけに閉じる**。
`DUMP` も BLE のデータ characteristic も本体でデコードしてから今まで通りの生 int16 を吐く。
これで `flash_dump.py` / `ble_probe.py` / Swift アプリが**すべて無変更**になり、
デコーダを C・Python・Swift の3本持つ事故も起きない。BLE の転送量は倍になるが、
満杯 2MB でも2分弱なので許容。旧形式の生ページ（0xA55A）も読めるので更新に ERASE も要らない。

**サイズは測って決めた**（`tools/codec_check.py --sweep`）:

| レコード | kブロック | バッファ | 6/21換算 | 7/28換算 |
|---|---|---|---|---|
| 256B | 64 | 120 | 5.86B 115分 | 5.46B 123分 |
| 512B | 64 | 200 | 5.60B 120分 | 5.27B 128分 |
| **1024B** | **64** | **384** | **5.47B 123分** | **5.16B 130分** |
| 2048B | 64 | 640 | 5.48B 123分 | 5.21B 129分 |
| 1024B | 64 | 256 | 5.69B 118分 | 5.47B 123分 |

- 最初 256B ページのまま作ったら **115分で2時間に届かなかった**。7/28 の見積もり（5.11 B/sample）が
  甘かったのではなく、あの計算が**256Bページの枠を課していなかった**（80サンプル塊で測っていた）ため。
  実際はヘッダ24Bが約44サンプルごとに乗って 0.55 B/sample 食う。
- レコードを伸ばすとヘッダは薄まるが、512B で頭打ちになり 1024B 以降ほぼ動かなかった。
  原因を「1つの k がレコード全体に合わなくなる」と読んで **k を64サンプルごとに取り直す**ようにしたが、
  k ヘッダ24bitのコストと相殺してほぼ収支ゼロだった（読みは外れ）。残してはある＝信号が非定常になっても崩れないので。
- **本当の律速はバッファ上限だった**。256サンプルで打ち切っていたのを384にしたら 5.69 → 5.47 に落ちた
  （静かな区間ほど1レコードに沢山入るのに、そこで頭を押さえていた）。ここが5分ぶん。
- **2次差分は悪化**（5.75 B/sample）。信号が滑らかだから効くかと思ったが、ジャイロのノイズが増幅される側が勝つ。
- C エンコーダが理論値に対して取りこぼしていないかは別途確認した（レコードあたり**1サンプル以内**まで詰まっている）。

**実機確認**（旧データを消さずに済む順序を選んだ）:
- 焼いた直後の `INFO` が `bytes_per_sample=12.81` — 旧ファームの生ページ 108,218 サンプルを新ファームがそのまま読めている
- `TESTLOG 20` → ちょうど 1040 サンプル追記。新規分だけ 3072B/1040 = **2.95 B/sample**（机上静止なので泳ぎより縮む）
- 吸い出して境界を確認: 旧ぶんは下位2bitがランダム（25.6%がゼロ）、**新規分は100%が4の倍数**＝圧縮経路を通った証拠。
  `|acc|` = 0.9985g（std 0.0005）で切り捨ての影響は見えない
- 時刻アンカーを圧縮レコードの間に2つ挟む → サンプル差 **416 = 8.0秒 ×52Hz ぴったり**。
  挟んだ後に吸い出しても既存サンプルはバイト一致＝**可変長レコードの走査**（今回いちばん壊れうる所）が実機で通った

**capacity は固定比率を仮定しない**。泳ぎ 6.3 / 更衣・休憩 4.4 B/sample とデータ依存なので、
`capacity_samples()` は**この個体が実際に達成している密度**を外挿する。`INFO` にも
`bytes_per_sample` / `recordable_min` を出した。アプリのゲージが勘のマージンでなく実測で動く。

**未検証**: BLE 経由の吸い出し（macOS の TCC で Terminal.app からしか叩けない）。
ただし BLE のフレーム組み立ては USB ダンプと `read_record()` を共有しているので、経路自体は同じコードを通る。
