ojimpo/mokkori-iq/(commit log)

2026-06-03 Phase 0: swim turn detection algorithm prototype
    - Threshold-based causal FSM turn detector for freestyle touch turns
    - Evaluated on Brunner et al. (ISWC 2019) wrist-worn smartwatch dataset
    - Freestyle F1=0.641, lap-time MAE=0.67s, cumulative drift=0.61s
    - Algorithm designed for Cortex-M4 portability (scalar ops, ring buffer, no future data)
    - Adaptive thresholds via peak-follower for cross-position robustness (Phase 1)
    [per_session_Backstroke.csv, per_session_Breaststroke.csv, per_session_Butterfly.csv, per_session_Freestyle.csv, per_subject_Backstroke.csv, per_subject_Breaststroke.csv, per_subject_Butterfly.csv, per_subject_Freestyle.csv]
2026-06-03 Phase 1: IMU bring-up firmware for XIAO nRF52840 Sense
    - firmware/imu_bringup: stream onboard LSM6DS3TR-C 6-axis IMU over USB CDC
    as CSV (millis,ax,ay,az,gx,gy,gz) at 104 Hz; drives the Sense IMU power rail
    - tools/serial_capture.py: host-side pyserial reader; reports effective
    sample rate, per-axis ranges and a gravity sanity check
    - toolchain: arduino-cli + Seeed nRF52 core; documented the python-on-PATH
    workaround (core build calls python, macOS only has python3 -> use venv bin)
    - verified on hardware: steady 104 Hz, |acc|=1.03 g at rest, axes respond
    [imu_bringup.ino, serial_capture.py]
2026-06-03 Phase 1: QSPI flash data-logger firmware
    - firmware/flash_logger: record 6-axis IMU to the 2 MB QSPI flash for pool
    sessions. Boot mode auto-selects from USB VBUS (battery -> log, USB ->
    console); raw int16 packed into 256 B pages; RGB LED status
    - needs explicit P25Q16H device for flash.begin() -- QSPI autodetect on the
    XIAO returns no match (jedec 0x856015)
    - console protocol: INFO / DUMP / ERASE / TESTLOG <sec> / HELP
    - tools/flash_dump.py: host driver; pulls the raw stream and converts to
    g / deg-per-second, with a --selftest round-trip
    - bench-verified: TESTLOG 5s -> 260 samples (52 Hz x 5), |acc|=1.03 g,
    flash->serial->CSV consistent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
2026-06-03 flash_logger: live USB mode switching + append-only logging
    Reworks the logger control flow for the 'swim short, plug into the laptop,
    pull & clear, swim again' workflow:
    - mode now follows USB VBUS live in loop() (no reset needed): unplugged ->
    log, plugged -> console, so plugging in is always ready to dump
    - logging is append-only; flash is cleared only by explicit ERASE, so
    unplugging to swim again never destroys data (scan ends on page magic,
    partial pages allowed mid-log so sessions can be appended)
    - tools/flash_dump.py: add --pull [PATH] = DUMP -> save CSV -> ERASE in one
    command (auto-names under data/swim/ if PATH omitted)
    - bench-verified: TESTLOG 2s x2 -> 105 then 210 samp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
    [flash_dump.py, flash_logger.ino]
2026-06-03 analysis: ingest device captures into the Phase 0 pipeline
    - dataio.load_swim_csv: load a flash_dump CSV into the same session dict as
    the Brunner loader; converts g -> m/s^2 and deg/s -> rad/s so the detector
    thresholds apply, infers fs from the timestamps
    - preprocessing.make_config_for_fs: re-design the low-pass biquad for an
    arbitrary rate (default.json is 30 Hz); reproduces the stored coeffs at 30 Hz
    - analysis/explore_swim.py: plot |acc| / activity+thresholds / |gyro| and
    overlay the wrist-tuned detector's detections
    - validated end-to-end on a bench capture (52 Hz at rest -> 0 detections)
2026-06-21 tools: autodetect /dev/ttyACM* serial port on Linux
    The pool-side capture host will be an Ubuntu tablet, where the XIAO's
    USB CDC port enumerates as /dev/ttyACM* rather than the macOS
    /dev/cu.usbmodem*. Add the Linux glob so flash_dump.py / serial_capture.py
    find the device without an explicit -p.
2026-06-21 tools: add touch-friendly Tkinter GUI for flash-logger capture
    flash_gui.py wraps flash_dump.py with three big buttons (PULL / INFO /
    ERASE) for one-tap swim capture on the Ubuntu tablet in the changing-room
    locker -- plug in, tap "吸い出して保存", unplug. Serial work reuses
    flash_dump's cmd_* functions and runs on a worker thread so the UI never
    freezes; ERASE asks for confirmation. Needs python3-tk on Ubuntu.
2026-06-21 data/swim: track capture dir in git with a README
    Swim captures (flash_dump --pull / flash_gui) land in data/swim/ and are
    NOT gitignored, so the tablet-pulls / push / Mac-pulls workflow works as-is.
    Add a README to bless the directory (present after clone) and document the
    capture/sync flow and CSV format.
2026-06-21 docs: add tablet handoff section to CLAUDE.md
    Claude's memory is per-machine and does not travel to the Ubuntu tablet,
    so consolidate the handoff into CLAUDE.md (auto-loaded on the tablet):
    current device/firmware state snapshot, first-time tablet setup, the
    pull/push/visualize flow, and the data-cable-direct-connection rule.
2026-06-21 docs: add pool capture protocol and BLE/Strava future vision
    Capture protocol (data採取手順): fixed mounting orientation (SeeedStudio
    face outward / USB-C up, logged per session; the magnitude-based detector
    is orientation-invariant but record it for future axis-level analysis),
    single continuous recording segmented by 3-tap markers, confirm green-blink
    before mounting, <=52 min total on-time, pull once at the end.
    Future vision: above-water BLE offload to a phone app for log viewing and
    Strava upload (BLE is water-blocked, so above-water only; the pool phase
    stays flash + USB). Antenna orientation matters in the BLE phase.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
2026-06-21 deps+docs: add pyserial to requirements; record tablet setup state
    - requirements.txt: add pyserial (flash_dump/flash_gui/serial_capture all import it)
    - CLAUDE.md: tablet setup needs python3-venv too (bare python3 lacks ensurepip);
    reorder apt before venv; note Ubuntu tablet provisioned 2026-06-21
    (venv+deps+tk+pyserial done; dialout usermod + device INFO still pending)
2026-06-21 data/swim: add first pool capture (2026-06-21, ~46min/144k samples)
    股間装着の初の実データ採取。52Hz・6軸・約2776秒。
    解析(可視化・再チューニング)は Mac 側で実施予定。
2026-06-21 docs: note recording-time (~52min) constraint and future extension options
    記録可能時間 約52分の出どころ(2MB÷12.8B/sample÷52Hz)と延長候補を
    将来構想セクションに追記。CSV容量とは別物である点も明記。
2026-06-21 analysis: add swim-bout/tap-marker segmentation tool
    初プール採取(swim_20260621_171349)の構造把握用。アクティビティ包絡で
    泳ぎ/休憩を分割し、静止区間のjerkインパルスから3タップ境界を探す。
    本セッションでは水中タップが分離不能と判明（陸上の冒頭タップのみ復元可）。
2026-06-21 analysis: gravity-orientation wall/turn/rest detector (turn_stand.py)
    オープンターン(毎回足をついて立つ)+ベンチ休憩という実際の泳ぎ方を利用。
    立位で股間デバイスの体軸が垂直化し重力z成分が泳ぎ-7.5→立位+9.5に振れる。
    この gz スイングが最も明確な壁シグネチャ(グライドギャップ/フリップ回転より遥かに良)。
    - gz>thr の立位エピソードを turn/rest/big-rest/tap に分類、ピークgz>5で半立ち除外+不応期12s
    - jerk領域で復元不能だった3タップが gz-立位領域では分離可(901/938s)
    - 外部GT皆無(プールにスマホ不可)のため内的整合性+妥当ペース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
2026-06-21 docs: record first-pool findings (gz-orientation wall detection)
    初プール採取(swim_20260621_171349)の所見をハンドオフに集約: オープンターン+
    ベンチ休憩という泳ぎ方、gz重力スイングが最良の壁シグネチャ、水中タップは
    jerk領域で不能だが立位gz領域で復元可、結果(block1≒525m/block2≒825m)、
    外部GT不在の制約と検証方針、再チューニングはgz主軸へ。
2026-06-21 analysis: add stroke-rate (SPM) tracker
    股間装着は体ロールのリズムが乗るのでケイデンス計測に好適。泳ぎ区間で
    ジャイロのロール軸のスペクトルピーク=ストロークサイクル率。本セッションは
    両半とも安定 30 cyc/min(≒60 arm strokes/min)、3手法一致。
    |acc|/|gyro|は整流harmonicsが出るので符号付き単軸で取る。CLAUDE.mdにも追記。
2026-06-21 docs: dated findings report for first pool capture (2026-06-21)
    初プール採取の解析所見を日付つきで集約: gz壁検出の突破口、距離/ペース結果
    (前半525m/後半825m/合計1350m)、3タップのgz復元、SPM計測(30cyc/min)、
    外部GT不在の制約、再チューニング方針。
2026-06-21 docs: add conservative-bias policy for distance/pace metrics
    距離・ペース算出は保守側に倒す方針を明文化: 距離は過小OK過大NG、
    ペースは遅めOK速めNG(盛らない)。実装は偽分割で増える方を潰し綺麗な
    レップはそのまま、怪しい連続区間だけ保守的に。端数は下に丸める。
2026-06-21 analysis: one-shot swim_report.py (distance/pace/SPM/Strava, conservative)
    取込CSV→一発で距離/ペース/レップ内訳/SPM/Strava用サマリを出力（デバイス完成形）。
    - turn_stand を detect_walls() に関数化し共有(DRY)、stroke_rate.dominant_cadence も再利用
    - 保守バイアス実装: レップごと 本数=min(壁カウント, round(泳ぎ時間/標準レングス時間))。
    偽分割の過大を潰しつつ検証済みの綺麗な100mは保持。距離は下振れ・ペースは遅め。
    - 標準レングス時間=ターン間の泳ぎ実時間(立位除外)中央値28.5s。分子と単位を揃える
    (start-start間隔だと立位混入で綺麗な1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
2026-06-21 docs: detailed decision log of tried/rejected wall-detection approaches
    採用に至るまで試した案を時系列で全記録(なぜ不採用かの理由込み):
    手首検出器/活動量分割/jerkタップ(水中復元不能)/活動ディップ壁(過大)/
    活動量自己相関(25m周期立たず)/フリップ回転(オープンターンで11個のみ)/
    グライドギャップ(gzの次点)/floor一律(綺麗な100mを削る)/normでのSPM(harmonics)。
    採用中の調整(ピークgz+不応期/min(壁,ペース)/標準レングス時間の単位バグ修正)も記録。
    別装着位置・別泳法では回転/グライドが復活し得るので手法として保存。findingsから参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
2026-06-21 docs: add session record (pseudo-GT) + fix rep-boundary model
    実際の泳ぎ方を取り違えていた点を訂正: 100mごとは水から上がらず数秒静止+
    トントンしてすぐ泳ぐ(水中)。ベンチ着座の長休憩はハーフ間の1回だけ。
    - data/swim/swim_20260621_171349.notes.md: 主観(泳ぎ方の記憶)と客観(検出構造)を
    併記した疑似GT。主観vs客観のズレ・次回申し送りも記載。
    - 境界は2信号で立つことを実証: 途中ターン≒3秒(タップ無)/100m境界≒7-17秒(トントン有)に
    継続時間が明確分離。トントンは無駄でなく有効(立位ゲートでjerk三連が長静止と一致)。
    - CLAUDE.md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
2026-06-21 analysis: feasibility study + causal sim for real-time 100m haptic feedback
    振動モーター未着のため実装前検討。因果オンライン版(realtime_sim.py)で
    録画データを模擬し、リアルタイム100m毎振動の実現性を評価。
    - 筋が良い: gz壁検出は絶対重力しきい値=適応閾値不要→MCUで1サンプル目から因果実行可。
    約20行の状態機械O(1)。振動は壁で直立確認の瞬間=立って止まってる時に届く理想タイミング。
    - 唯一の課題: オープンループのカウントドリフト(先読み補正不可)。本セッションで
    causal1250m vs 保守1150m(+8%)。対策: スタートアンカー/ト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
2026-06-21 docs: rewrite README around purpose and target system (Phase 1)
    Phase0(手首データ+旧FSM)中心の古い内容を刷新。目的→完成形(ロガー/
    リアルタイム振動/BLE→Strava)→仕組み(gzオリエンテーション壁検出)→ハード
    →現状、の構成に。実機採取・gz検出・SPM・保守集計・振動検討の現状を反映。
2026-06-21 feat(flash_logger): report battery voltage/SoC/charging in INFO
    Read VBAT (P0.31) via the VBAT_ENABLE (P0.14) divider against the 3.0V
    internal reference (12-bit, 16x averaged), undo the 1M/0.51M divider, and
    add a line to INFO: # vbat_mv=4015 pct=82 charging=1
    No dedicated charge-status GPIO is broken out, so `charging` is derived
    from VBUS present & mv < 4150 (so a topped-off pack reads charging=0).
    Host side: flash_dump.py --info and flash_gui.py INFO now surface the
    battery line. Firmware compiles clean; on-device verification pending
    (device not connected). Divider ratio may need a multimeter calibration.
    [flash_dump.py, flash_gui.py, flash_logger.ino]
2026-06-21 docs: Phase 2 BLE time-sync design (iPhone/Swift, tap-triggered, anchor model)
    Capture the decisions made for the smartphone app phase, to be worked on
    while the vibration motor (haptics/enclosure) is unavailable:
    - Platform: iPhone native Swift (SwiftUI + CoreBluetooth). iPhone-only and
    the USB-pull tablet is retired by BLE, so Flutter's cross-platform value
    doesn't apply; the app's core is talking to a custom BLE peripheral, where
    CoreBluetooth's lack of an abstraction layer wins.
    - Time: MCU can't keep a clock while off; phone writes an epoch, device
    appends an anchor (sample-index K = epoch E) to flash as a new 0xA55B page;
    host reconstructs each sample's absolute time as E+(i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
2026-07-28 data/swim: add second pool capture (2026-07-28, ~52min/164k samples)
    2回目のプール採取。52Hz・6軸・約3150秒でフラッシュ満杯まで到達。
    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
2026-07-28 feat(flash_logger): drive coin ERM motor (VIB cmd + periodic in-pool buzz)
    - VIB [ms] [pct] console command for bench feel/intensity tests
    - non-blocking double pulse every 60 s while logging so the in-water
    perceptibility test rides along with normal data collection
    - low-side BSS138 switch on D10, analogWrite-only control, motor forced
    off at session end
2026-07-28 docs: start DEVLOG.md work journal; motor circuit + PATH fix in CLAUDE.md
    - DEVLOG.md mirrors new Cosense page mokkori-iq 進捗ログ (pulse-pump style)
    - CLAUDE.md: journal practice, ERM motor purchase/circuit/commands,
    arduino-cli PATH must be absolute ($PWD) — relative fails under Go exec
2026-07-28 docs(devlog): BSS138 mounted on SOT-23 adapter, pin mapping confirmed
2026-07-28 docs: waterproof power-switch decision (magnet/tap over sealed physical switch)
    Prototype keeps the SS-12D00G3 slide switch; final sealed enclosure drops
    the through-hole switch for a reed/hall magnet switch or tap-to-wake, since
    any moving seal is an eventual leak path.
2026-07-28 docs: add perfboard wiring layout diagram (coordinate-labeled, BSS138 2x4)
    Coordinate grid (cols 1-12, rows A-G) placing the XIAO (USB-C left) with
    GND/3V3/D10 on socket row F, BSS138 adapter as a 2x4 footprint (drain end
    up), and the 10-wire driver net in the right free zone + a row-G GND rail.
    Self-contained HTML, viewable on phone.
2026-07-28 feat(analysis): orientation-independent wall detection (verticality projection)
    verticality() self-calibrates per session: swim gravity from high-gyro
    samples, stand gravity from short repeated vertical episodes (anchored on
    wall stands, not bench sits), projects onto the swim->stand axis and maps
    to the canonical gz scale. detect_walls/report thresholds unchanged.
    Validated on swim_20260728 (device tossed in at a random orientation):
    block1 = 24 wall stands -> 625m, matching the swimmer's own count exactly.
    Old session totals unchanged (475/675/1150m); tap-triple recovery is lost
    on the projected signal (known trade-off, see module docstring).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
2026-07-28 docs: Phase 2 design — wall-interval review screen, phone offload, raw-data retention
    Device keeps only recording + a causal wall counter (for haptics); the
    non-causal analysis pipeline moves to the phone over a full BLE raw dump.
    Pre-Strava confirmation screen lists wall-to-wall intervals with outlier
    highlighting; manual fixes double as labeled ground truth. Raw data is
    retained app-side so improved detectors can reprocess past sessions.
    Shrinks the C-port scope to the causal counter; Swift port uses the
    Python pipeline as the reference implementation.
2026-07-28 docs(plan): Garmin-metric matrix; per-length stroke count validated on real data
    Zero-crossing count of the band-passed best gyro axis gives 15 roll
    cycles per 25m (IQR 14-15) on both sessions, agreeing with the spectral
    estimate within +/-1. A roll cycle maps 1:1 to Garmin's watch-arm stroke
    count, so strokes/length, SWOLF (~44) and DPS (~1.67m) are all derivable.
    Matrix marks HR-based metrics as unavailable (no sensor) and stroke-type
    as fixed-label. Python reference lands in swim_report first, then the
    Swift port.
2026-07-28 feat(app): MokkoriCore Swift package — turn_stand/swim_report port, parity green
    Phase A step 2-3: CSV loader (unit conversion + fs inference), numpy-compatible
    median/percentile, EMA, verticality self-calibration, detect_walls (classify ->
    de-fragment union -> rhythm recovery -> tap triples), and the report math
    (typical length time, rep split, banker's-rounded pace estimate, min() physical
    cap). XCTest parity suite pins the same expectations as regression_check.py
    (6/21: 35/13/2 rec@724 500+675=1175m, 7/28: 41/1/3 rec@533 625+425=1050m) and
    both sessions pass via swift test on macOS.
2026-07-28 feat: per-length Garmin metrics (strokes/SWOLF/DPS/best pace) — Python reference + Swift parity
    swim_report.py grows the reference implementation: RBJ bandpass biquad (causal
    DF2T, 0.3-1.2Hz) -> prone-gated hysteresis zero-cross on the best gyro axis,
    counted per wall-to-wall length. No FFT/scipy so the Swift port (StrokeCounter
    in MokkoriCore) uses identical arithmetic — stroke totals match Python exactly
    (6/21: 647 over 47/47 lengths, 7/28: 576 over 42/42; median 14/length, SWOLF
    avg 44 best 38, DPS 1.79m). Expectations pinned in both regression_check.py
    (2/2 PASS) and ParityTests (swift test green). App report screen shows the
    stroke/SWOLF summary row and a per-length section with bes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
2026-07-28 feat(app): Strava upload — dedicated OAuth app, manual time anchor, convention-compliant post
    Phase B. Strava allows one API application per account and strava-autopilot
    already owns the main account's slot, so mokkori-iq registers its own app under
    a separate account and the main account authorizes it (owner and athlete may
    differ). StravaService uses ASWebAuthenticationSession against the *web*
    oauth/authorize — the mobile endpoint app-switches to Strava and the callback
    lands outside the auth session. client_secret and tokens live in the Keychain;
    refreshing is safe here because the client is ours alone.
    StravaSummary (in MokkoriCore, so the convention is testable) builds the post:
    t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
2026-07-28 refactor(app): post to Strava through the autopilot gateway instead of its own OAuth
    Corrects the previous commit's premise. Strava's June 2026 developer program
    change requires a paid subscription for Standard Tier API access, so registering
    a second app under a free account — what the last commit assumed — is not
    possible. The main account's single app slot is already taken by strava-autopilot
    (and, it turns out, shared verbatim with health-ojimpo, which even holds a copy
    of the same token).
    So the app no longer authorizes anything itself: it POSTs to the gateway
    endpoint added to strava-autopilot, authenticated with an X-API-Key. The NAS
    stays the only token holder, so no second auth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
2026-07-28 docs: health-ojimpo now borrows the Strava token from the gateway too
    Records that the shared-token fragility found while wiring Phase B is resolved:
    autopilot is the only refresher, health-ojimpo asks it per fetch, and Strava
    re-authorization must happen on the autopilot side or the token chain branches
    again.
2026-07-28 docs: add an app-development handoff note and publish the autopilot repo
    docs/app_handoff.md is the entry point for picking app work up in a fresh
    session: current state per phase, the commands that matter, what the parity
    rules are and why breaking them shows up as a red test, what is left, and the
    traps already paid for (SwiftUI Section initializer, Cloudflare eating 5xx
    bodies, generated files that must not be committed).
2026-07-28 perf(app): read the CSV with strtod instead of Strings, and add UI tests for the screens
    Stage timings showed the import wait is not the analysis (detect 0.03s, report
    0.01s) but the CSV read: 2.32s for 163k rows, which would be several times worse
    on the phone. FastCSV walks the bytes with strtod instead of building a String
    and a Substring array per line — 2.32s to 0.03s. strtod rounds identically to
    Double(String), and the binary round-trip test already compares the arrays bit
    for bit, so the parity expectations are untouched. Restored the header check the
    rewrite dropped, with a test that a foreign 8-column CSV is refused rather than
    silently analyzed.
    The three screens had never actu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
2026-07-28 docs: design the per-length pace chart for the report screen
    Requested as Strava's lap pace chart transposed: distance runs down the vertical
    axis, one bar per 25m length, 1000m in a single screen, average pace overlaid.
    The design lands on bars diverging from the average rather than a plain bar from
    zero. Pace spans only 1:42-2:17/100m, so a zero baseline leaves every bar between
    75% and 100% of full and the one slow length — the thing this chart exists to
    surface — disappears; cropping the axis to fix that would exaggerate differences
    into a lie. Anchoring at the average makes bar length the actual deviation, and
    the requested average line becomes the baseline it is measured from.
    Ba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
2026-07-28 docs: switch the pace chart to left-aligned bars after re-reading the goal
    The chart exists to answer two questions — did the swim build or fade over
    1000m, and is there an obviously bad length — and diverging-from-average serves
    neither well: bars spread both ways from the centre, so the outline forks and
    there is no single edge to follow down the page. Left-aligned bars turn the
    right-hand edge into the pace profile itself.
    That brings back the zero-baseline problem, so it got measured rather than
    argued: on 7/28's 42 lengths at an assumed 300pt plot width, a 10s/100m drift
    moves the bar end 20.9pt from a zero baseline versus 67.6pt with the axis
    cropped to the data. Twenty-one points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
2026-07-28 refactor: rename swim concepts to standard terms, restyle the report screen
    "半", "レップ" and "本" were made up for this project and read as nothing
    in particular — 本 even reads as "book". Replaced with the terms Garmin
    (JA) and Japanese swim practice actually use: ラップ (one pool length),
    インターバル (continuous swimming between rests), セット (a chunk
    separated by a big rest), レスト. Renamed the code identifiers along with
    the UI so the old words cannot creep back in.
    Set numbers used to be the detection-block index, so the pre-entry and
    shower blocks ate numbers and 7/28 started at "半2 / 半3". Sets are now
    counted from 1 over blocks that actually contain sw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
2026-07-28 feat(app): two-tab layout (device / log) and haptic feedback settings
    The device tab gathers everything about the hardware: log import, battery
    and memory, time sync, memory erase, and the vibration settings. The log
    tab is the previous screen. Strava settings stay where they were, top
    left of the log tab, since that is the only thing left to configure.
    Only import and the vibration settings actually work — everything that
    needs to talk to the device says "未接続" and is disabled rather than
    quietly showing blanks. DeviceStatus already mirrors what INFO returns,
    so Phase D fills it in and enables the buttons.
    Vibration is three fixed patterns, each assigned a distance (or left
    unset).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
2026-07-28 feat(app): app icon, log totals, and a tidier device screen
    The icon is drawn in code (tools/make_icon.py) rather than by an image
    model, so the shape and palette are values we can keep tuning. Picked the
    lane path — down a lane, U-turn at the wall, repeat — over a swimmer
    glyph, in pool blue. Candidates and the Liquid Glass layer export live in
    docs/icon_candidates.
    The log tab opens with the running totals (distance, time, average pace,
    count) instead of just the word "ログ", and rows lead with the date and
    time rather than the filename. The date is the dump time parsed out of
    the filename, which is not when the swim happened, so the row says
    "吸い出し" next to it; once a sessio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
2026-07-28 docs: log the icon, log totals and device-screen regrouping
2026-07-28 feat(app): M-shaped icon, appearance variants, "Mokkori IQ" on the home screen
    One more bend: four lanes instead of three, starting upward, so the path
    turns twice at the top and reads as a rounded M — still literally a
    there-and-back pool course. serpentine() now takes the lane count and
    direction, so the S and W shapes are one argument away.
    A single icon image gets darkened by the system in dark mode — checked on
    the home screen, the pool blue came out navy. Contents.json now declares
    light, dark and tinted variants so the blue stays blue, with the tinted
    one supplying just the mark on transparency. iOS 26 puts its own glass
    sheen on the flat PNG, which is a fine place to stop for no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
2026-07-28 feat: M icon with lifted legs; verify 2-hour recording by decimating real data
    The icon gets a fourth lane and starts upward, so it turns twice at the top
    and reads as an M. The two outer legs stop short of the baseline, leaving
    the middle arc as the only thing touching the bottom — the turns still meet
    the wall, so it stays a there-and-back course.
    A municipal pool slot is two hours, so recording two hours means never
    losing the end of a session. Capacity is a measured 163,840 samples, so the
    recordable time is just that over the rate: 26Hz gives 105 minutes and misses
    it; 13Hz gives 210 minutes.
    analysis/decimate_check.py answers whether 13Hz still works by decimating the
    two real capt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
2026-07-28 docs: what averaging before decimation actually costs
    Measured the swim-band spectrum: 3-13% of the power sits above 6.5Hz, so
    the averaging is doing anti-aliasing, not denoising. The detector already
    smooths harder downstream (1s EMA on gravity, a 0.3-1.2Hz bandpass for
    strokes), which is why the measured distance does not move at all. What we
    actually give up is transients shorter than the window and, more to the
    point, the high-frequency content itself — a session recorded at 13Hz can
    never be reprocessed for something we have not thought of yet.
2026-07-28 docs: measure on-device compression — lossless tops out at ~95 minutes
    Keeping 52Hz means keeping the bandwidth a future detector might want, so
    the question is whether compression can buy the two hours instead of
    decimation. Measured on the real captures: first-order deltas have an
    entropy of 6.9-7.2 bytes/sample, so no lossless scheme reaches the 5.60
    budget — Rice coding gets to 6.6-7.0 and that is the ceiling, not a
    shortcoming of the coder.
    Dropping the low 2 bits first gets to 5.1-5.5 (123-132 minutes). That
    trades resolution rather than bandwidth, which is the right way round for
    this project: the analyses we might want later (wall-touch impact, tap
    recovery) live in the high fre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
2026-07-28 docs: settle the 2-hour question — truncate resolution, never bandwidth
    Verified what low-bit truncation actually costs by re-running the whole
    report on truncated data: nothing moves. Distance, sets, laps, stroke
    total and SWOLF are identical at every level from 0 to 4 bits on both
    sessions — even the stroke total, which decimation did shift.
    That only shows the current detector is insensitive, so the line goes at
    the sensor's noise floor instead: 2 bits quantises to 0.28mg RMS against
    an accelerometer noise of about 0.46mg, so it is lossless in information
    terms; 4 bits is plainly coarser than the sensor.
    Swapping the flash is out — it sits on the XIAO module, and the XIAO
    stays, s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
2026-07-28 docs: 2 bits is the right cut — my margin was an extrapolation from swim-heavy data
    Called 2-bit truncation thin at 123 minutes against a 120-minute slot.
    Both halves of that were wrong: you leave a two-hour slot with time to
    spare, so the recording is shorter than 120 minutes, and the two captures
    we have are swim-heavy because the flash fills at 52 minutes.
    Measured the two regimes separately: swimming costs 6.3 bytes/sample,
    everything else — changing, resting, the shower — costs 4.3-4.7, and a
    real visit is mostly the latter (7/28 was 40% swimming). At that mix 2
    bits gives about 131 minutes, and swimming would have to exceed 63% of
    the recording before two hours stopped fitting.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
2026-07-31 docs: record the device-install path and what the phone changed
    First run on real hardware, so CLAUDE.md and the handoff now carry the
    devicectl sequence and the three things that stop it: pairing needs the
    phone unlocked, the developer-app trust entry only appears after install,
    and system_profiler returns nothing under the sandbox.
    Also note why the pace tooltip moved onto the bar, and that chart taps in
    UI tests have to go through tapChart.
2026-07-31 docs: log the device run and the tooltip revisions
2026-07-31 feat(firmware): talk to the phone over BLE and record time anchors
    The device tab in the app had every button that needs the hardware greyed
    out, so this adds the side it was waiting for.
    BLE advertises whenever the device is powered, including while logging. The
    design doc's original plan was to wake the radio on a tap pattern, but the
    thresholds for that have to be tuned against real swimming data before they
    can be trusted not to miss the wake -- and "I tapped it and nothing happened"
    poolside is worse than the advertising current. A connected central pauses
    logging, which is free (the phone only ever talks to us out of the water) and
    keeps flash writes away from the dump being served.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
2026-07-31 feat(app): connect to the device over BLE and pull logs from the phone
    Everything on the device tab that was greyed out now works: battery, memory,
    time sync, erase, and pulling the log straight off the device -- which is the
    point of the whole thing, because it retires the Ubuntu tablet in the locker.
    The dump arrives as the same int16 layout raw.bin already uses, so BLE and CSV
    imports converge on one persist() path and produce identical analysis. Frames
    carry an absolute sample index, so a gap or a mid-transfer disconnect fails
    loudly instead of writing a plausible-looking short session.
    A time anchor on the device gives the app the absolute start time, so the
    Strava upload no longer ne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
2026-07-31 docs: record the BLE bring-up and the two hardware surprises
    Also writes down why BLE ended up always-on instead of tap-woken, since the
    design doc says the opposite and the reason (a missed wake poolside beats the
    advertising current) isn't recoverable from the code.
2026-07-31 fix(firmware): give the battery ADC enough acquisition time
    The gauge returned either 3715 or 4103 mV at random -- 47% or 92%, which is
    useless to show. The first guess was a too-short settle delay; lengthening it
    changed nothing.
    The real cause is the core's default 3 us acquisition time against a ~340k
    divider (1M || 0.51M), where the datasheet wants 40 us. The sampling capacitor
    never charges, so a conversion mostly returns the previous one's residue --
    and averaging doesn't rescue it, because consecutive reads of the same channel
    simply agree with each other. Hence two attractors instead of noise.
2026-07-31 perf(ble): read the MTU when the dump starts, not when the link opens
    Pulling 187 kB took 45 s. iOS negotiates the MTU during service discovery, so
    at connect time getMtu() still reports the 23-byte default -- which sized every
    notification at one sample. Moving the calculation to DUMP_START gets the full
    20 samples per frame and the same pull now finishes in under 5 s, so a full
    2 MB flash takes under a minute instead of eight.
    Also caches scan_log(), which walks every used page and ran twice a second
    while dumping; the log provably cannot grow while a central is connected,
    because that's exactly when logging is paused.
    The transfer row used to sit on "estimating" for the whole (now short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
2026-07-31 feat(firmware): compress the log so a 2-hour pool slot fits
    The flash held 53 minutes at 52 Hz, but a public pool books you for two
    hours, so a long session ran out before the swim did. Decimating to 13 Hz
    would have fit and measured identical reports, but it throws the
    high-frequency content away for good -- and the whole reason we keep raw
    data is so a better detector can reprocess old sessions later.
    So compress instead: first-order delta -> zigzag -> Rice, with the low two
    bits dropped first. Two bits is below the accelerometer's own noise (0.28 mg
    of quantisation against 0.46 mg RMS), so it costs resolution we never had
    rather than bandwidth. That gives 5.16-5.47 B/sample on the two ca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
2026-07-31 docs: record what the compression measurement actually said
    The 2026-07-28 estimate (5.11 B/sample) was measured on 80-sample blocks
    without imposing the 256-byte page, so it undercounted the header. The first
    implementation came in at 115 minutes because of it -- worth writing down,
    since the same mistake is easy to repeat the next time a scheme gets sized on
    paper.
    Also records the two readings that turned out wrong: k locality was not what
    capped larger records (it roughly breaks even against the k header), and the
    buffer cap was. And the hardware run, which mattered most for the mixed
    legacy/compressed stream and the variable-length record stepping.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
2026-07-31 feat(app): sync the clock on connect instead of asking for a tap
    The device forgets the time whenever the switch cuts power, so every
    recording run needs an anchor before its data is worth a timestamp. Making
    that a button means the one time it gets forgotten is the one session whose
    Strava start time has to be typed in by hand -- and you only find out later.
    Connecting already happens at exactly the right moment: you talk to the
    device after getting out, and sampling ran continuously at 52 Hz for the
    whole power-on, so a single anchor at the end reconstructs everything before
    it.
    Only anchors when the log has grown since the last one, so walking past the
    device doesn't sprinkle anchor pag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
